antmicro/cm4-baseboard/assets/previews/layer1_thumbnail.webp

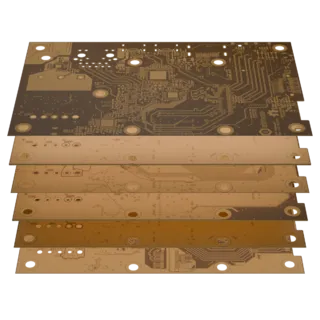
assets/previews/layer1_thumbnail.webp
