antmicro/cm4-baseboard/assets/previews/leftT_thumbnail.png

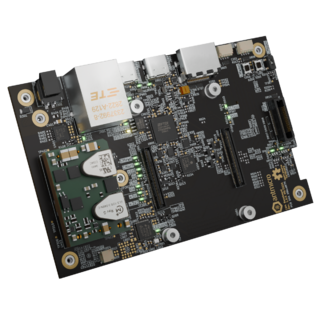
assets/previews/leftT_thumbnail.png
