antmicro/cm4-baseboard/assets/previews/layer0_thumbnail.webp

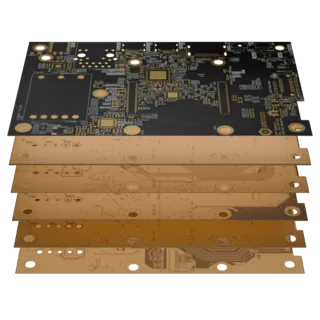
assets/previews/layer0_thumbnail.webp
