antmicro/cm4-baseboard/assets/previews/layer3.png

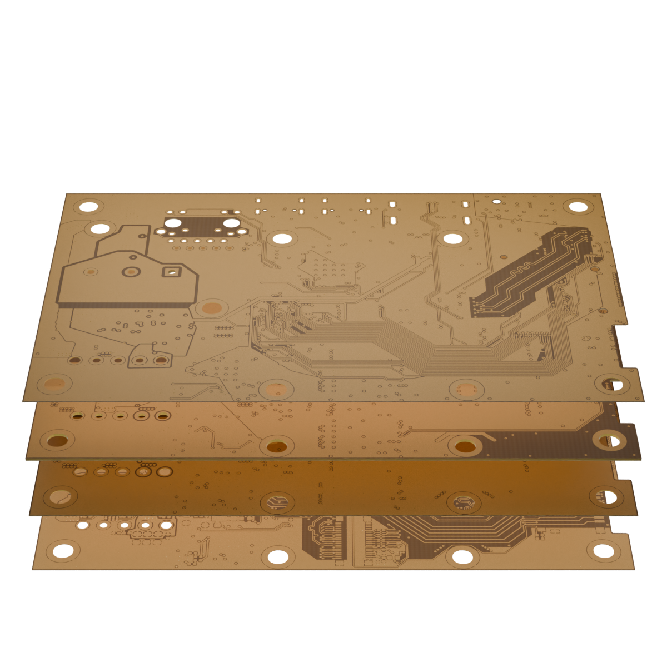
assets/previews/layer3.png
