antmicro/cm4-baseboard/assets/previews/layer5.png

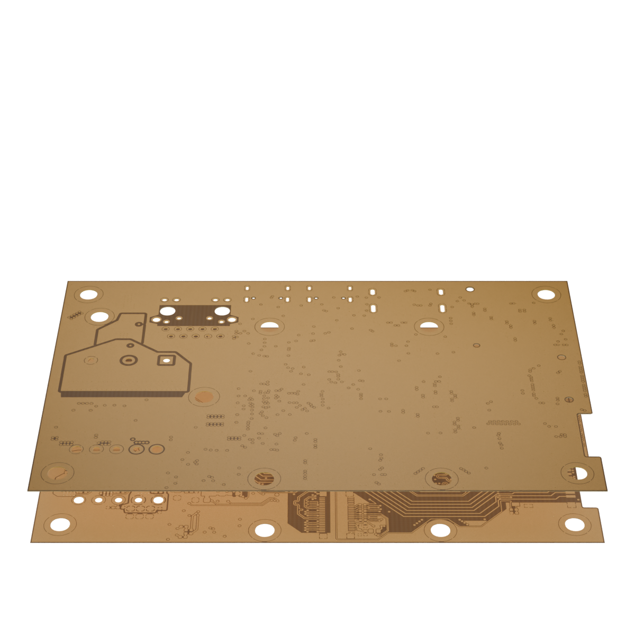
assets/previews/layer5.png
