antmicro/cm4-baseboard/assets/previews/layer6.png

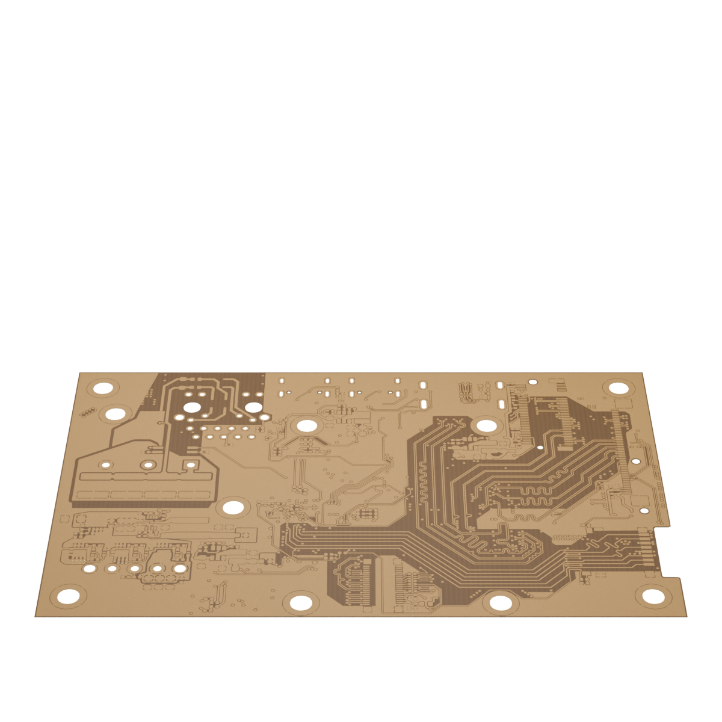
assets/previews/layer6.png
