antmicro/cm4-baseboard/assets/previews/orthoB_photo.webp

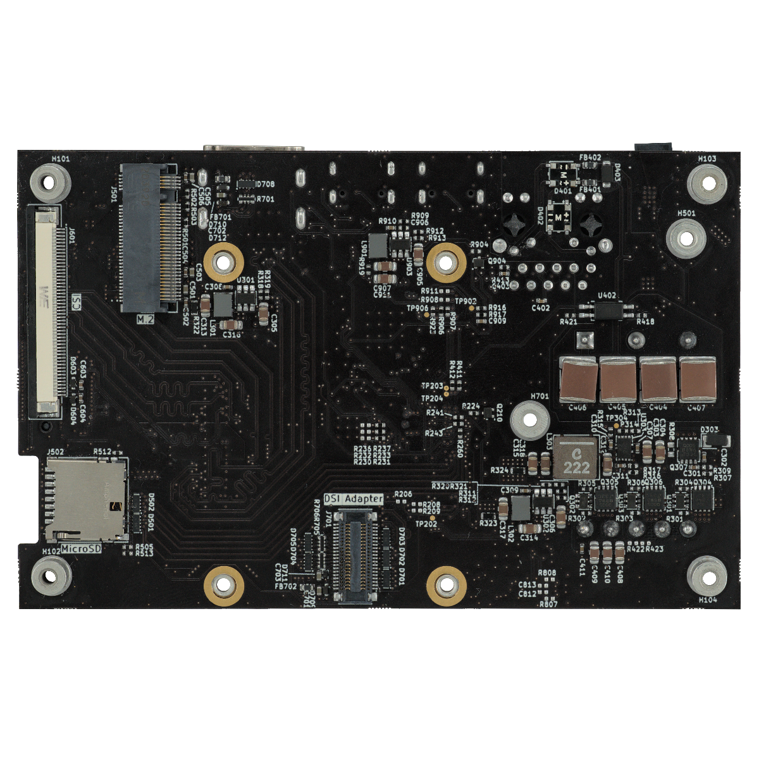
assets/previews/orthoB_photo.webp
