antmicro/cm4-baseboard/assets/previews/orthoT_photo.webp

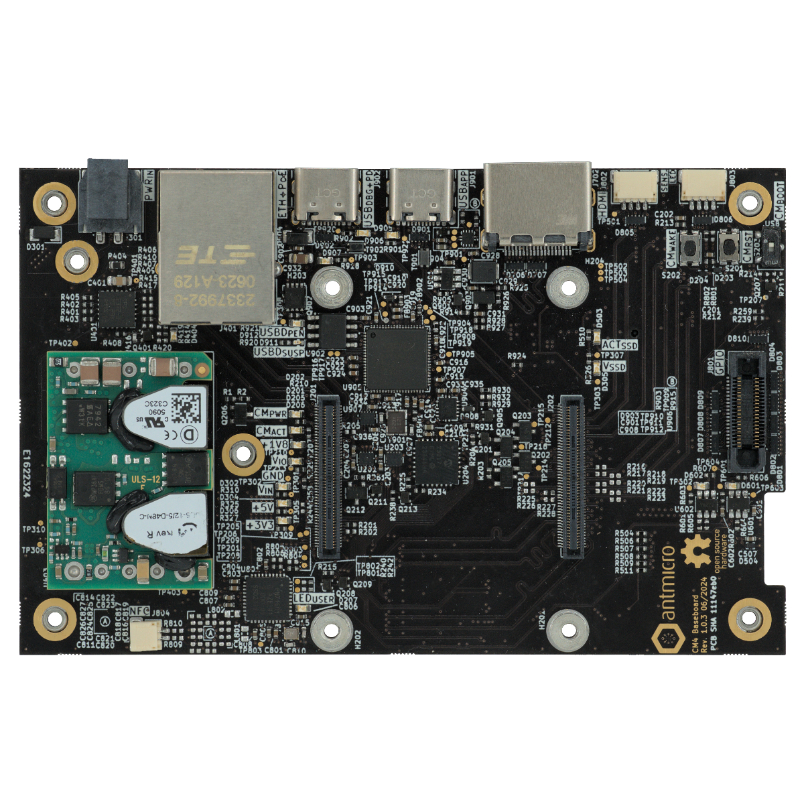
assets/previews/orthoT_photo.webp
