antmicro/cm4-baseboard/assets/wireframe/wireframe_dimensions.png

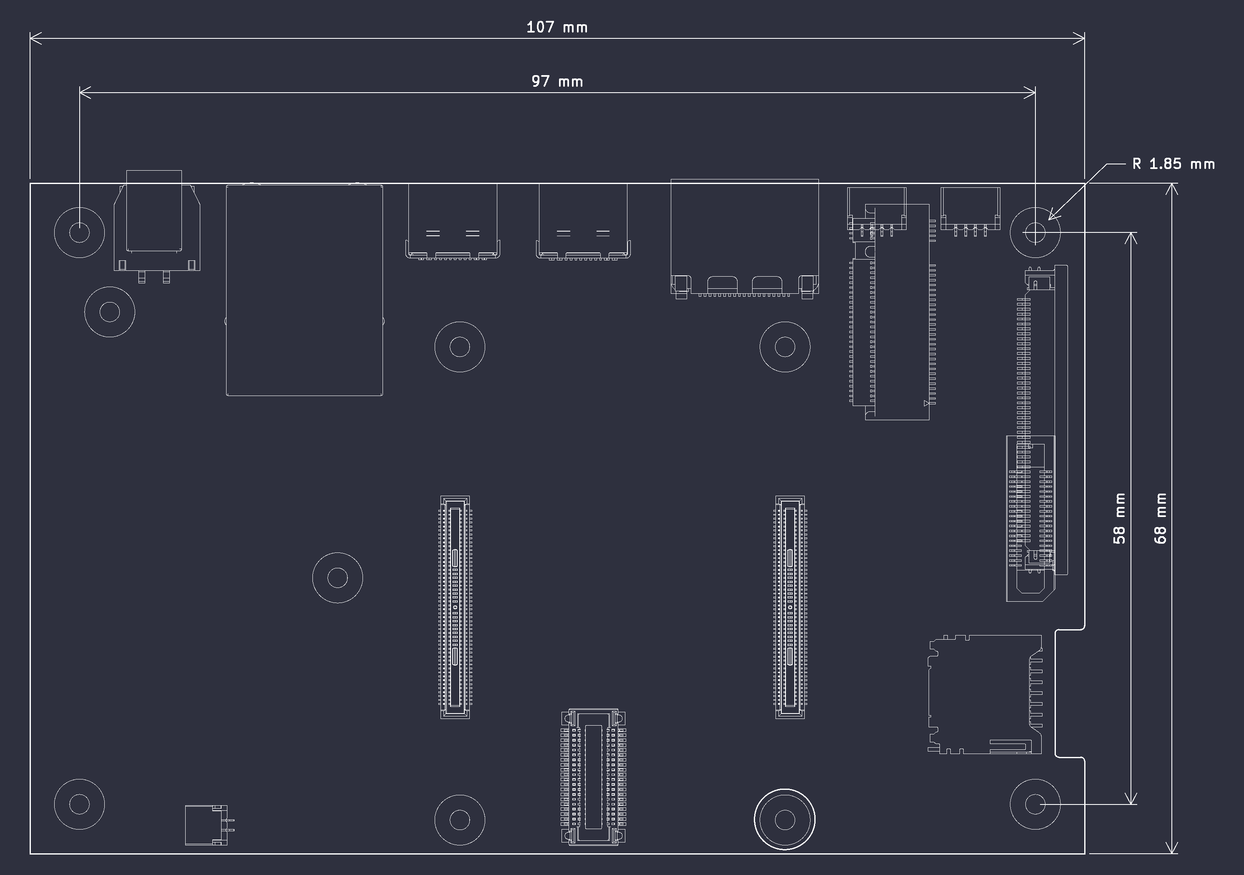
assets/wireframe/wireframe_dimensions.png
