antmicro/cm4-baseboard/assets/wireframe/wireframe_dimensions_bottom.png

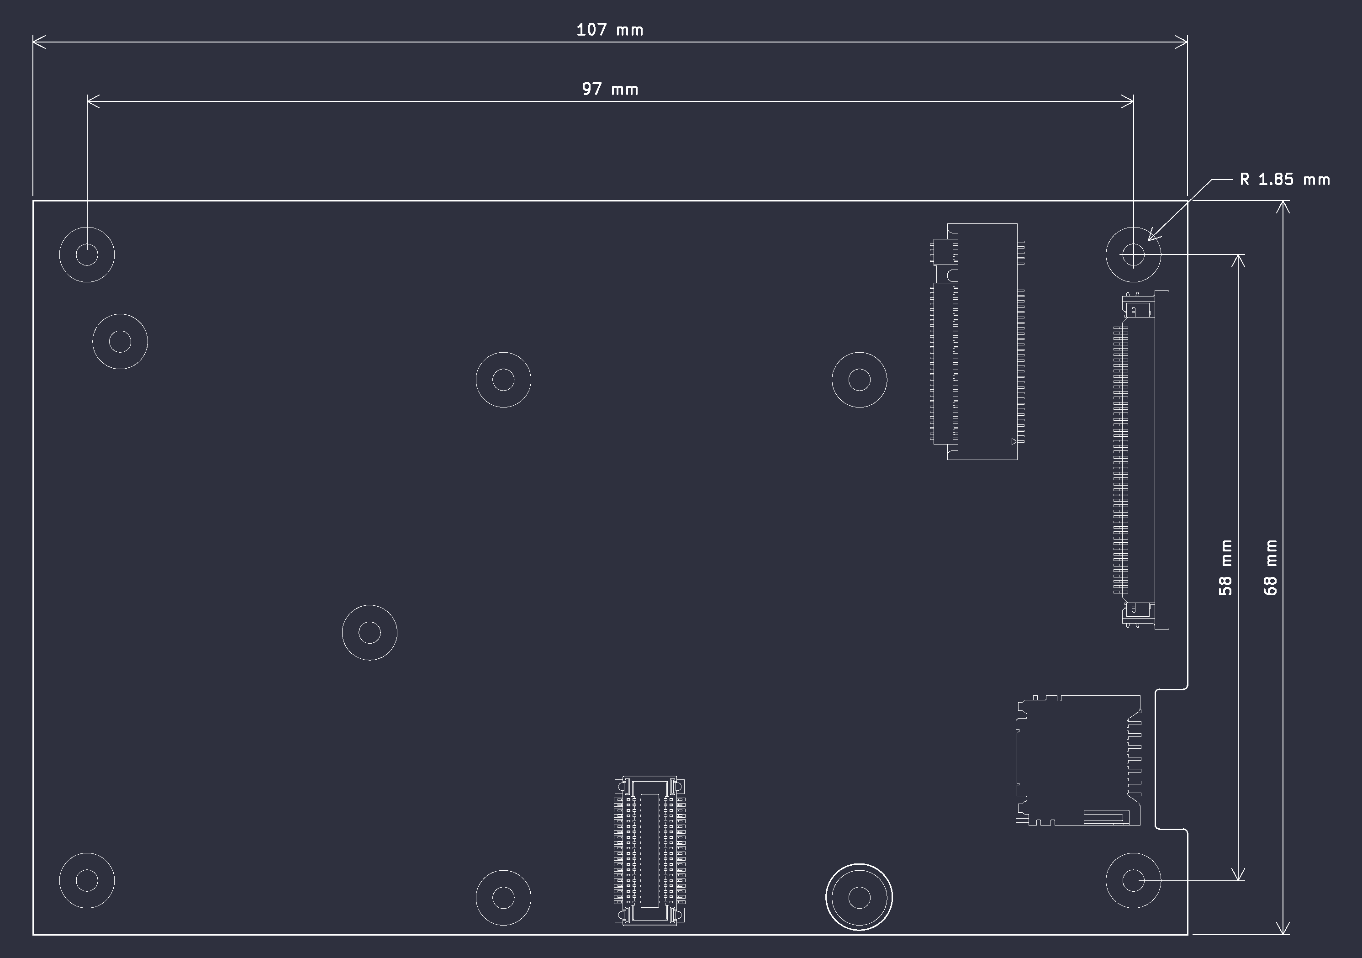
assets/wireframe/wireframe_dimensions_bottom.png
