antmicro/cm4-baseboard/cm4-baseboard.kicad_sch

## KiCad design cm4-baseboard.kicad_sch (2024-09-13)

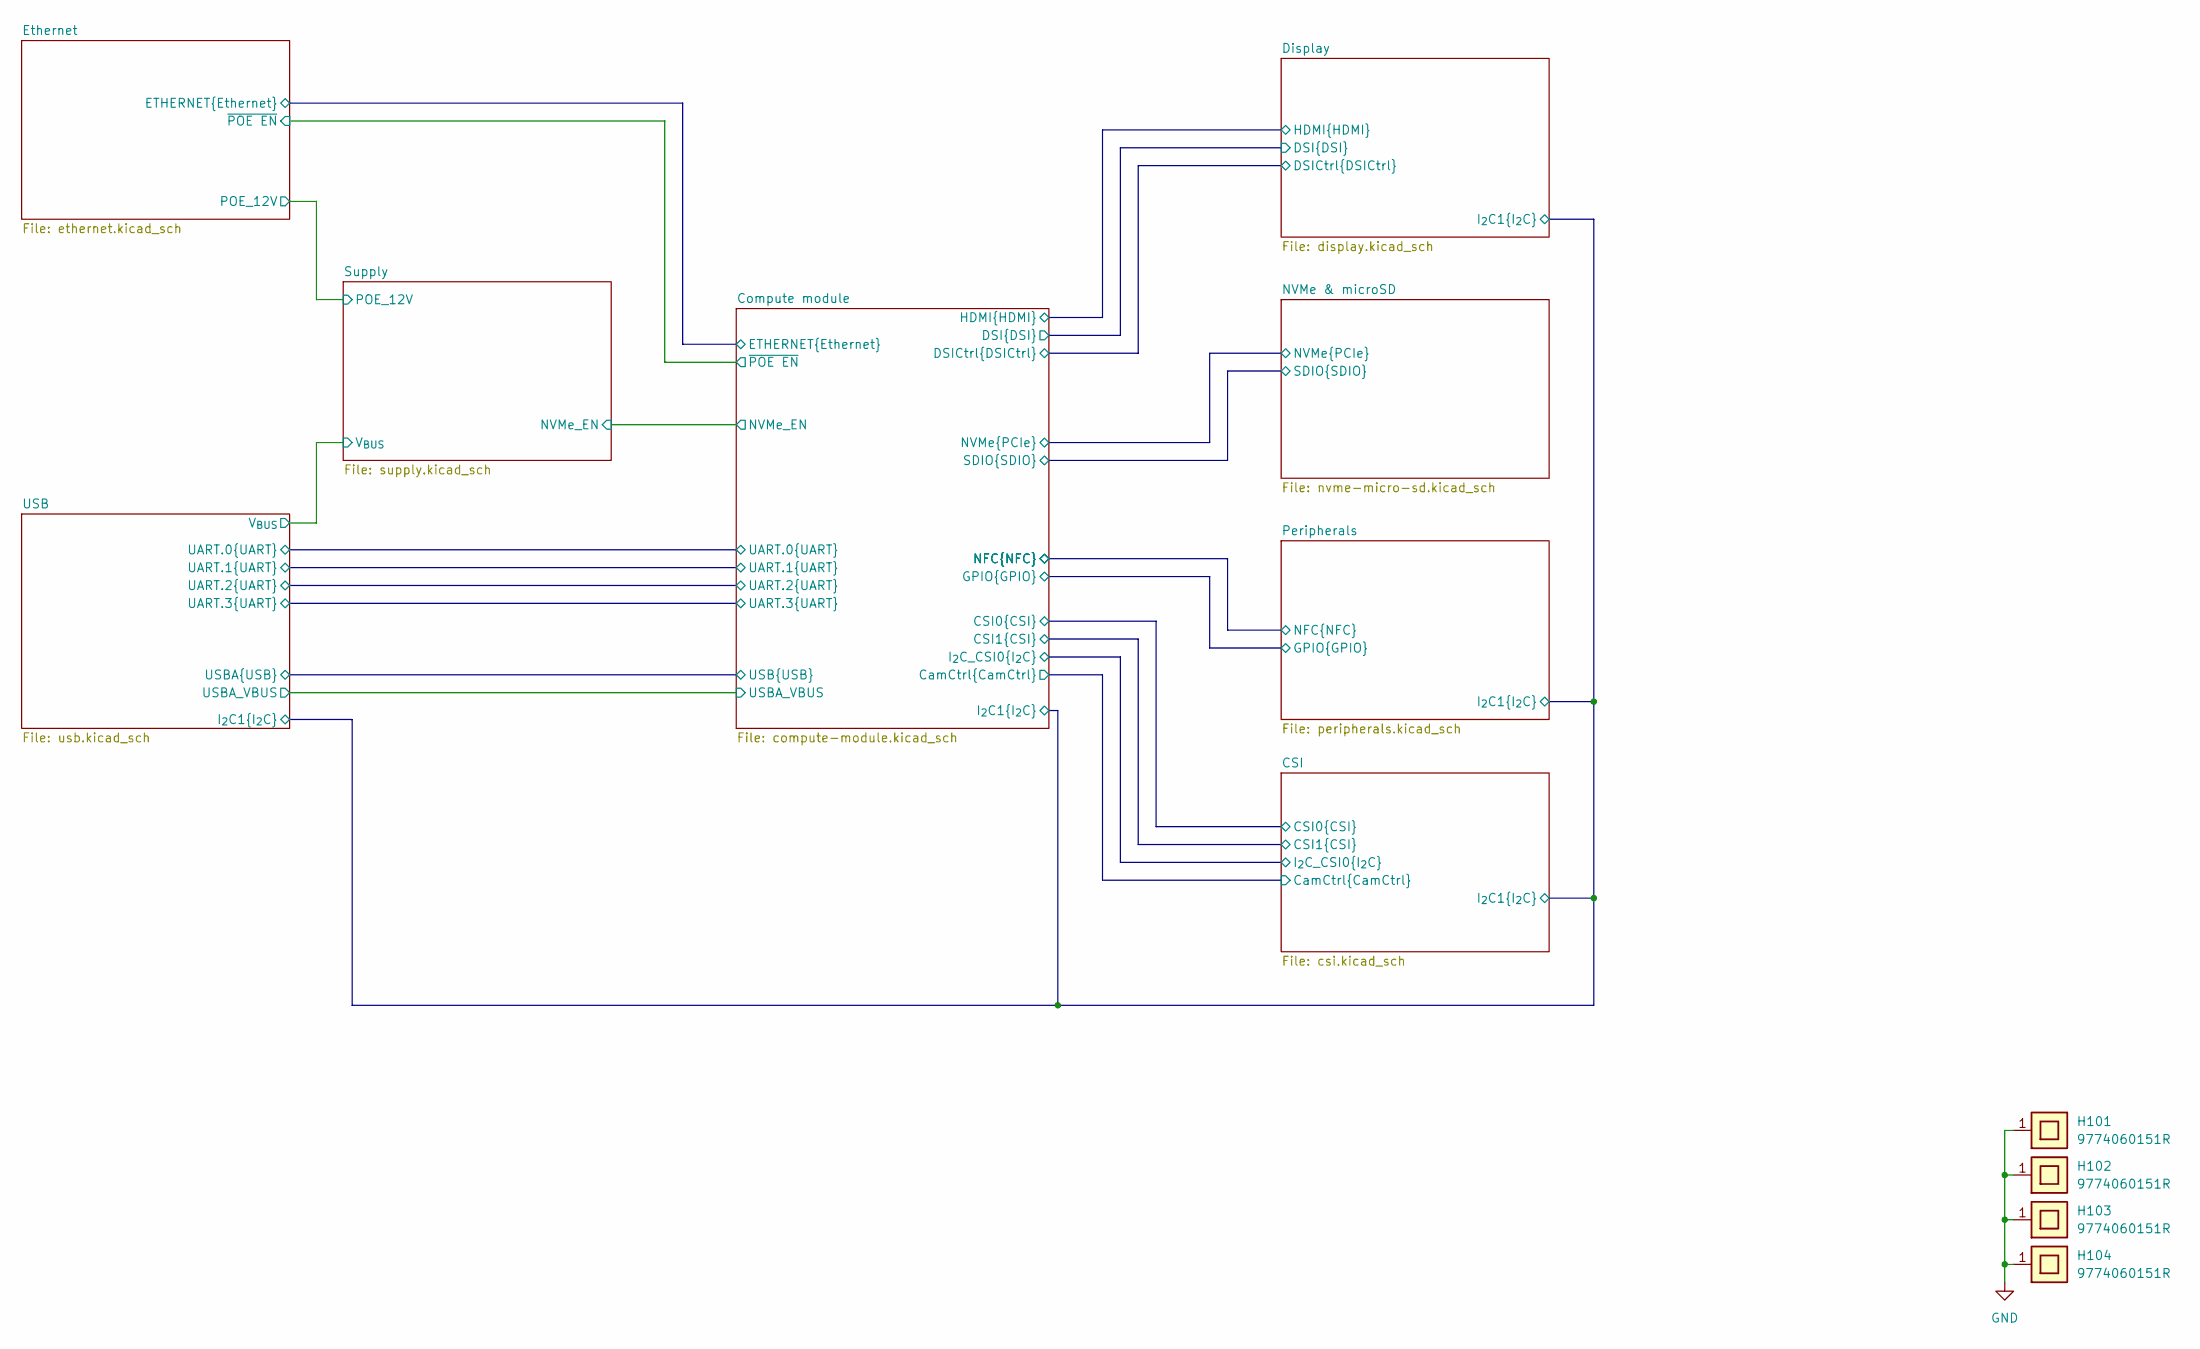
[picture p21: schematic cm4-baseboard.kicad_sch]

Parts:
H101, H102, H103, H104: Spacer_Drill3.7mm_H6mm_9774060151R; MPN 9774060151R

Connections:
GND: H101.1, H102.1, H103.1, H104.1
