antmicro/cm4-baseboard/compute-module.kicad_sch

## KiCad design compute-module.kicad_sch (2024-09-13)

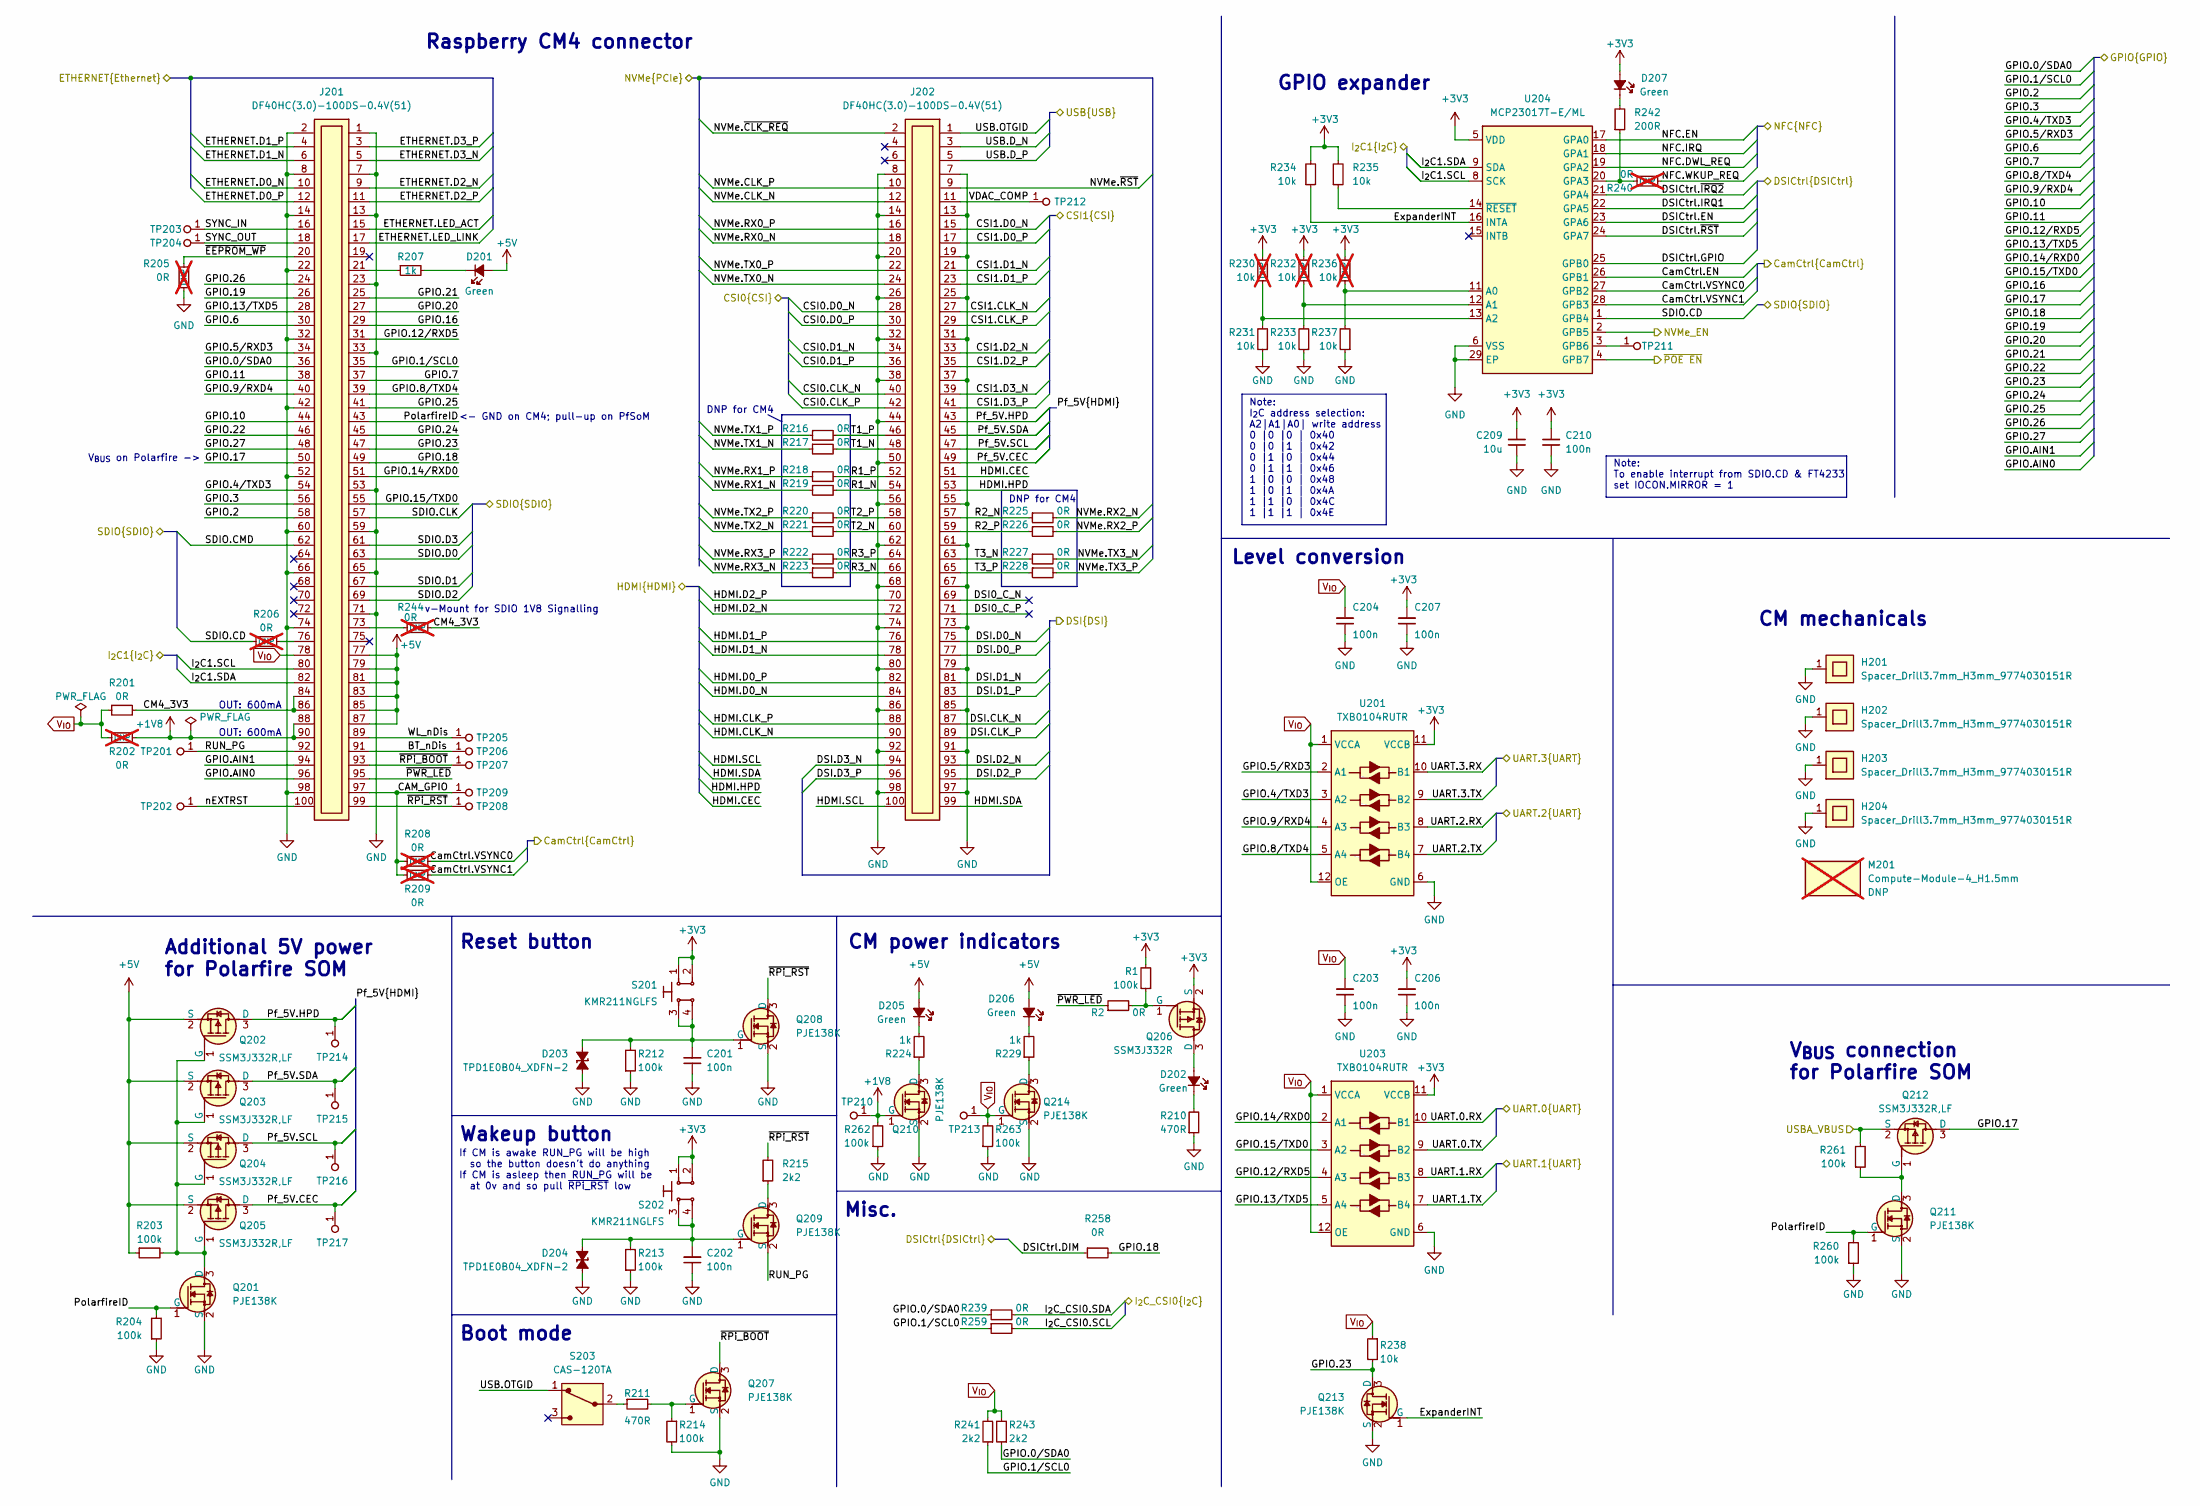
[picture p22: schematic compute-module.kicad_sch]

Parts:
C201, C202, C203, C204, C206, C207, C210: C_100n_0402; C_0402_1005Metric; Voltage 50V; MPN GRM155R61H104KE14D
C209: C_10u_0402; C_0402_1005Metric; MPN CC0402MRX5R5BB106
D201, D202, D205, D206, D207: LED_G_0603_KP-1608CGCK; LED_0603_1608Metric_G; MPN KP-1608CGCK
D203, D204: TPD1E0B04_XDFN-2; XDFN-2_1x0.60mm; MPN TPD1E0B04DPYR
H201, H202, H203, H204: Spacer_Drill3.7mm_H3mm_9774030151R; MPN 9774030151R
J201, J202: Socket_Hirose_DF40_2x50_DF40HC-3.0-100DS-0.4V; Conn_Socket_Hirose_DF40_2x50_DF40HC-3.0-100DS-0.4V; MPN DF40HC(3.0)-100DS-0.4V(51)
M201: Compute-Module-4_H1.5mm; MPN SC0294; not fitted
Q201, Q207, Q208, Q209, Q210, Q211, Q213, Q214: PJE138K; SOT-523; MPN PJE138K_R1_00001
Q202, Q203, Q204, Q205, Q206, Q212: SSM3J332R; SOT-23-3; MPN SSM3J332R,LF
R1, R203, R204, R212, R213, R214, R260, R261, R262, R263: R_100k_0402; R_0402_1005Metric; Tolerance 1%; MPN CR0402-FX-1003GLF
R2, R201, R216, R217, R218, R219, R220, R221, R222, R223, R225, R226, R227, R228, R239, R258, R259: R_0R_0402; R_0402_1005Metric; MPN ERJ2GE0R00X
R202, R205, R206, R208, R209, R240, R244: R_0R_0402; R_0402_1005Metric; MPN ERJ2GE0R00X; not fitted
R207, R224, R229: R_1k_0402; R_0402_1005Metric; Tolerance 1%; MPN CR0402-FX-1001GLF
R210, R211: R_470R_0402; R_0402_1005Metric; Tolerance 1%; MPN CR0402-FX-4700GLF
R215, R241, R243: R_2k2_0402; R_0402_1005Metric; Tolerance 1%; MPN CR0402-FX-2201GLF
R230, R232, R236: R_10k_0402; R_0402_1005Metric; Tolerance 1%; MPN CR0402-FX-1002GLF; not fitted
R231, R233, R234, R235, R237, R238: R_10k_0402; R_0402_1005Metric; Tolerance 1%; MPN CR0402-FX-1002GLF
R242: R_200R_0402; R_0402_1005Metric; Tolerance 1%; MPN CR0402-FX-2000GLF
S201, S202: SW_KMR211NGLFS_SMD; MPN KMR211NGLFS
S203: CAS-120TA; Switch_Slide_CAS-120TA; MPN CAS-120TA
TP201, TP202, TP203, TP204, TP205, TP206, TP207, TP208, TP209, TP210, TP211, TP212, TP213, TP214, TP215, TP216, TP217: TP_0.75mm_SMD; TP_SMD_0.75mm
U201, U203: TXB0104_UQFN; UQFN-12_2x1.7mm_P0.4mm_Texas_RUT; MPN TXB0104RUTR
U204: MCP23017T-E_QFN; QFN-28-1EP_6x6mm_P0.65mm_EP3.7x3.7mm; MPN MCP23017T-E/ML

Connections:
+1V8: J201.88, J201.90, Q210.1 (G), R202.2, R262.2, TP210.1
+3V3: C206.2, C207.2, C209.2, C210.2, D207.2 (A), Q206.2 (S), R1.2, R230.2, R232.2, R234.2, R235.2, R236.2, S201.1, S201.2, S202.1, S202.2, U201.11 (VCCB), U203.11 (VCCB), U204.5 (VDD)
+5V: D201.2 (A), D205.2 (A), D206.2 (A), J201.77, J201.79, J201.81, J201.83, J201.85, J201.87, Q202.2 (S), Q203.2 (S), Q204.2 (S), Q205.2 (S), R203.1
BT_nDis: J201.91, TP206.1
CAM_GPIO: J201.97, R208.1, R209.1, TP209.1
CM4_3V3: J201.84, J201.86, R201.2, R244.1
CSI0.CLK_N: J202.40
CSI0.CLK_P: J202.42
CSI0.D0_N: J202.28
CSI0.D0_P: J202.30
CSI0.D1_N: J202.34
CSI0.D1_P: J202.36
CSI1.CLK_N: J202.27
CSI1.CLK_P: J202.29
CSI1.D0_N: J202.15
CSI1.D0_P: J202.17
CSI1.D1_N: J202.21
CSI1.D1_P: J202.23
CSI1.D2_N: J202.33
CSI1.D2_P: J202.35
CSI1.D3_N: J202.39
CSI1.D3_P: J202.41
CamCtrl.EN: U204.26 (GPB1)
CamCtrl.VSYNC0: R208.2, U204.27 (GPB2)
CamCtrl.VSYNC1: R209.2, U204.28 (GPB3)
DSI0_C_N: J202.69
DSI0_C_P: J202.71
DSI.CLK_N: J202.87
DSI.CLK_P: J202.89
DSI.D0_N: J202.75
DSI.D0_P: J202.77
DSI.D1_N: J202.81
DSI.D1_P: J202.83
DSI.D2_N: J202.93
DSI.D2_P: J202.95
DSI.D3_N: J202.94
DSI.D3_P: J202.96
DSICtrl.DIM: R258.1
DSICtrl.EN: U204.23 (GPA6)
DSICtrl.GPIO: U204.25 (GPB0)
DSICtrl.IRQ1: U204.22 (GPA5)
DSICtrl.~IRQ2: U204.21 (GPA4)
DSICtrl.~RST: U204.24 (GPA7)
ETHERNET.D0_N: J201.10
ETHERNET.D0_P: J201.12
ETHERNET.D1_N: J201.6
ETHERNET.D1_P: J201.4
ETHERNET.D2_N: J201.9
ETHERNET.D2_P: J201.11
ETHERNET.D3_N: J201.5
ETHERNET.D3_P: J201.3
ETHERNET.LED_ACT: J201.15
ETHERNET.LED_LINK: J201.17
ExpanderINT: Q213.1 (G), R234.1, U204.16 (INTA)
GND: C201.1, C202.1, C203.1, C204.1, C206.1, C207.1, C209.1, C210.1, D203.1 (C), D204.1 (C), H201.1, H202.1, H203.1, H204.1, J201.1, J201.2, J201.7, J201.8, J201.13, J201.14, J201.22, J201.23, J201.32, J201.33, J201.42, J201.52, J201.53, J201.59, J201.60, J201.65, J201.66, J201.71, J201.74, J201.98, J202.7, J202.8, J202.13, J202.14, J202.19, J202.20, J202.25, J202.26, J202.31, J202.32, J202.37, J202.38, J202.44, J202.50, J202.55, J202.56, J202.61, J202.62, J202.67, J202.68, J202.73, J202.74, J202.79, J202.80, J202.85, J202.86, J202.91, J202.92, J202.97, J202.98, Q201.2 (S), Q207.2 (S), Q208.2 (S), Q210.2 (S), Q211.2 (S), Q213.2 (S), Q214.2 (S), R204.1, R205.1, R210.1, R212.1, R213.1, R214.2, R231.1, R233.1, R237.1, R260.1, R262.1, R263.1, U201.6 (GND), U203.6 (GND), U204.6 (VSS), U204.29 (EP)
GPIO.0/SDA0: J201.36, R239.1, R243.1
GPIO.1/SCL0: J201.35, R241.1, R259.1
GPIO.2: J201.58
GPIO.3: J201.56
GPIO.4/TXD3: U201.3 (A2)
GPIO.4/TXD3: J201.54
GPIO.5/RXD3: U201.2 (A1)
GPIO.5/RXD3: J201.34
GPIO.6: J201.30
GPIO.7: J201.37
GPIO.8/TXD4: U201.5 (A4)
GPIO.8/TXD4: J201.39
GPIO.9/RXD4: U201.4 (A3)
GPIO.9/RXD4: J201.40
GPIO.10: J201.44
GPIO.11: J201.38
GPIO.12/RXD5: U203.4 (A3)
GPIO.12/RXD5: J201.31
GPIO.13/TXD5: U203.5 (A4)
GPIO.13/TXD5: J201.28
GPIO.14/RXD0: J201.51, U203.2 (A1)
GPIO.15/TXD0: J201.55, U203.3 (A2)
GPIO.16: J201.29
GPIO.17: J201.50, Q212.3 (D)
GPIO.18: J201.49, R258.2
GPIO.19: J201.26
GPIO.20: J201.27
GPIO.21: J201.25
GPIO.22: J201.46
GPIO.23: J201.47, Q213.3 (D), R238.2
GPIO.24: J201.45
GPIO.25: J201.41
GPIO.26: J201.24
GPIO.27: J201.48
GPIO.AIN0: J201.96
GPIO.AIN1: J201.94
HDMI.CEC: J202.51
HDMI.CLK_N: J202.90
HDMI.CLK_P: J202.88
HDMI.D0_N: J202.84
HDMI.D0_P: J202.82
HDMI.D1_N: J202.78
HDMI.D1_P: J202.76
HDMI.D2_N: J202.72
HDMI.D2_P: J202.70
HDMI.HPD: J202.53
HDMI.SCL: J202.100
HDMI.SDA: J202.99
I_{2}C1.SCL: J201.80, U204.8 (SCK)
I_{2}C1.SDA: J201.82, U204.9 (SDA)
I_{2}C_CSI0.SCL: R259.2
I_{2}C_CSI0.SDA: R239.2
NFC.DWL_REQ: U204.19 (GPA2)
NFC.EN: U204.17 (GPA0)
NFC.IRQ: U204.18 (GPA1)
NFC.WKUP_REQ: R240.2
NVMe.CLK_N: J202.12
NVMe.CLK_P: J202.10
NVMe.RX0_N: J202.18
NVMe.RX0_P: J202.16
NVMe.RX1_N: R219.1
NVMe.RX1_P: R218.1
NVMe.RX2_N: R225.2
NVMe.RX2_P: R226.2
NVMe.RX3_N: R223.1
NVMe.RX3_P: R222.1
NVMe.TX0_N: J202.24
NVMe.TX0_P: J202.22
NVMe.TX1_N: R217.1
NVMe.TX1_P: R216.1
NVMe.TX2_N: R221.1
NVMe.TX2_P: R220.1
NVMe.TX3_N: R227.2
NVMe.TX3_P: R228.2
NVMe.~CLK_REQ: J202.2
NVMe.~RST: J202.9
NVMe_EN: U204.2 (GPB5)
unnamed: C201.2, D203.2 (A), Q208.1 (G), R212.2, S201.3, S201.4
unnamed: C202.2, D204.2 (A), Q209.1 (G), R213.2, S202.3, S202.4
unnamed: D201.1 (C), R207.2
unnamed: D202.1 (C), R210.2
unnamed: D202.2 (A), Q206.3 (D)
unnamed: D205.1 (C), R224.2
unnamed: D206.1 (C), R229.2
unnamed: D207.1 (C), R242.2
unnamed: J201.21, R207.1
unnamed: J201.73, R244.2
unnamed: J201.76, R206.1
unnamed: Q201.3 (D), Q202.1 (G), Q203.1 (G), Q204.1 (G), Q205.1 (G), R203.2
unnamed: Q206.1 (G), R1.1, R2.2
unnamed: Q207.1 (G), R211.2, R214.1
unnamed: Q209.3 (D), R215.1
unnamed: Q210.3 (D), R224.1
unnamed: Q211.3 (D), Q212.1 (G), R261.1
unnamed: Q214.3 (D), R229.1
unnamed: R211.1, S203.2
unnamed: R230.1, R231.2, U204.13 (A2)
unnamed: R232.1, R233.2, U204.12 (A1)
unnamed: R235.1, U204.14 (~RESET)
unnamed: R236.1, R237.2, U204.11 (A0)
unnamed: R240.1, R242.1, U204.20 (GPA3)
unnamed: TP211.1, U204.3 (GPB6)
Pf_5V.CEC: J202.49, Q205.3 (D), TP217.1
Pf_5V.HPD: J202.43, Q202.3 (D), TP214.1
Pf_5V.SCL: J202.47, Q204.3 (D), TP216.1
Pf_5V.SDA: J202.45, Q203.3 (D), TP215.1
PolarfireID: J201.43, Q201.1 (G), Q211.1 (G), R204.2, R260.2
R1_N: J202.54, R219.2
R1_P: J202.52, R218.2
R2_N: J202.57, R225.1
R2_P: J202.59, R226.1
R3_N: J202.66, R223.2
R3_P: J202.64, R222.2
RUN_PG: J201.92, Q209.2 (S), TP201.1
SDIO.CD: R206.2, U204.1 (GPB4)
SDIO.CLK: J201.57
SDIO.CMD: J201.62
SDIO.D0: J201.63
SDIO.D1: J201.67
SDIO.D2: J201.69
SDIO.D3: J201.61
SYNC_IN: J201.16, TP203.1
SYNC_OUT: J201.18, TP204.1
T1_N: J202.48, R217.2
T1_P: J202.46, R216.2
T2_N: J202.60, R221.2
T2_P: J202.58, R220.2
T3_N: J202.63, R227.1
T3_P: J202.65, R228.1
UART.0.RX: U203.10 (B1)
UART.0.TX: U203.9 (B2)
UART.1.RX: U203.8 (B3)
UART.1.TX: U203.7 (B4)
UART.2.RX: U201.8 (B3)
UART.2.TX: U201.7 (B4)
UART.3.RX: U201.10 (B1)
UART.3.TX: U201.9 (B2)
USB.D_N: J202.3
USB.D_P: J202.5
USB.OTGID: J202.1, S203.1
USBA_VBUS: Q212.2 (S), R261.2
VDAC_COMP: J202.11, TP212.1
V_{IO}: C203.2, C204.2, J201.78, Q214.1 (G), R201.1, R202.1, R238.1, R241.2, R243.2, R263.2, TP213.1, U201.1 (VCCA), U201.12 (OE), U203.1 (VCCA), U203.12 (OE)
WL_nDis: J201.89, TP205.1
nEXTRST: J201.100, TP202.1
~EEPROM_WP: J201.20, R205.2
~POE EN: U204.4 (GPB7)
~PWR_LED: J201.95, R2.1
~RPi_BOOT: J201.93, Q207.3 (D), TP207.1
~RPi_RST: J201.99, Q208.3 (D), R215.2, TP208.1

Notes on the sheet:
Boot mode
Misc.
OUT: 600mA
DNP for CM4
Wakeup button
Raspberry CM4 connector
v-Mount for SDIO 1V8 Signalling
If CM is awake RUN_PG will be high so the button doesn't do anything If CM is asleep then RUN_PG will be at 0v and so pull ~{RPi_RST} low
GPIO expander
Additional 5V power for Polarfire SOM
<- GND on CM4; pull-up on PfSoM
Level conversion
Note: To enable interrupt from SDIO.CD & FT4233 set IOCON.MIRROR = 1
V_{BUS} connection for Polarfire SOM
CM mechanicals
V_{BUS} on Polarfire ->
Note: I_{2}C address selection: A2|A1|A0| write address 0 |0 |0 | 0x40 0 |0 |1 | 0x42 0 |1 |0 | 0x44 0 |1 |1 | 0x46 1 |0 |0 | 0x48 1 |0 |1 | 0x4A 1 |1 |0 | 0x4C 1 |1 |1 | 0x4E
CM power indicators
Reset button
