antmicro/cm4-baseboard/csi.kicad_sch

## KiCad design csi.kicad_sch (2024-09-13)

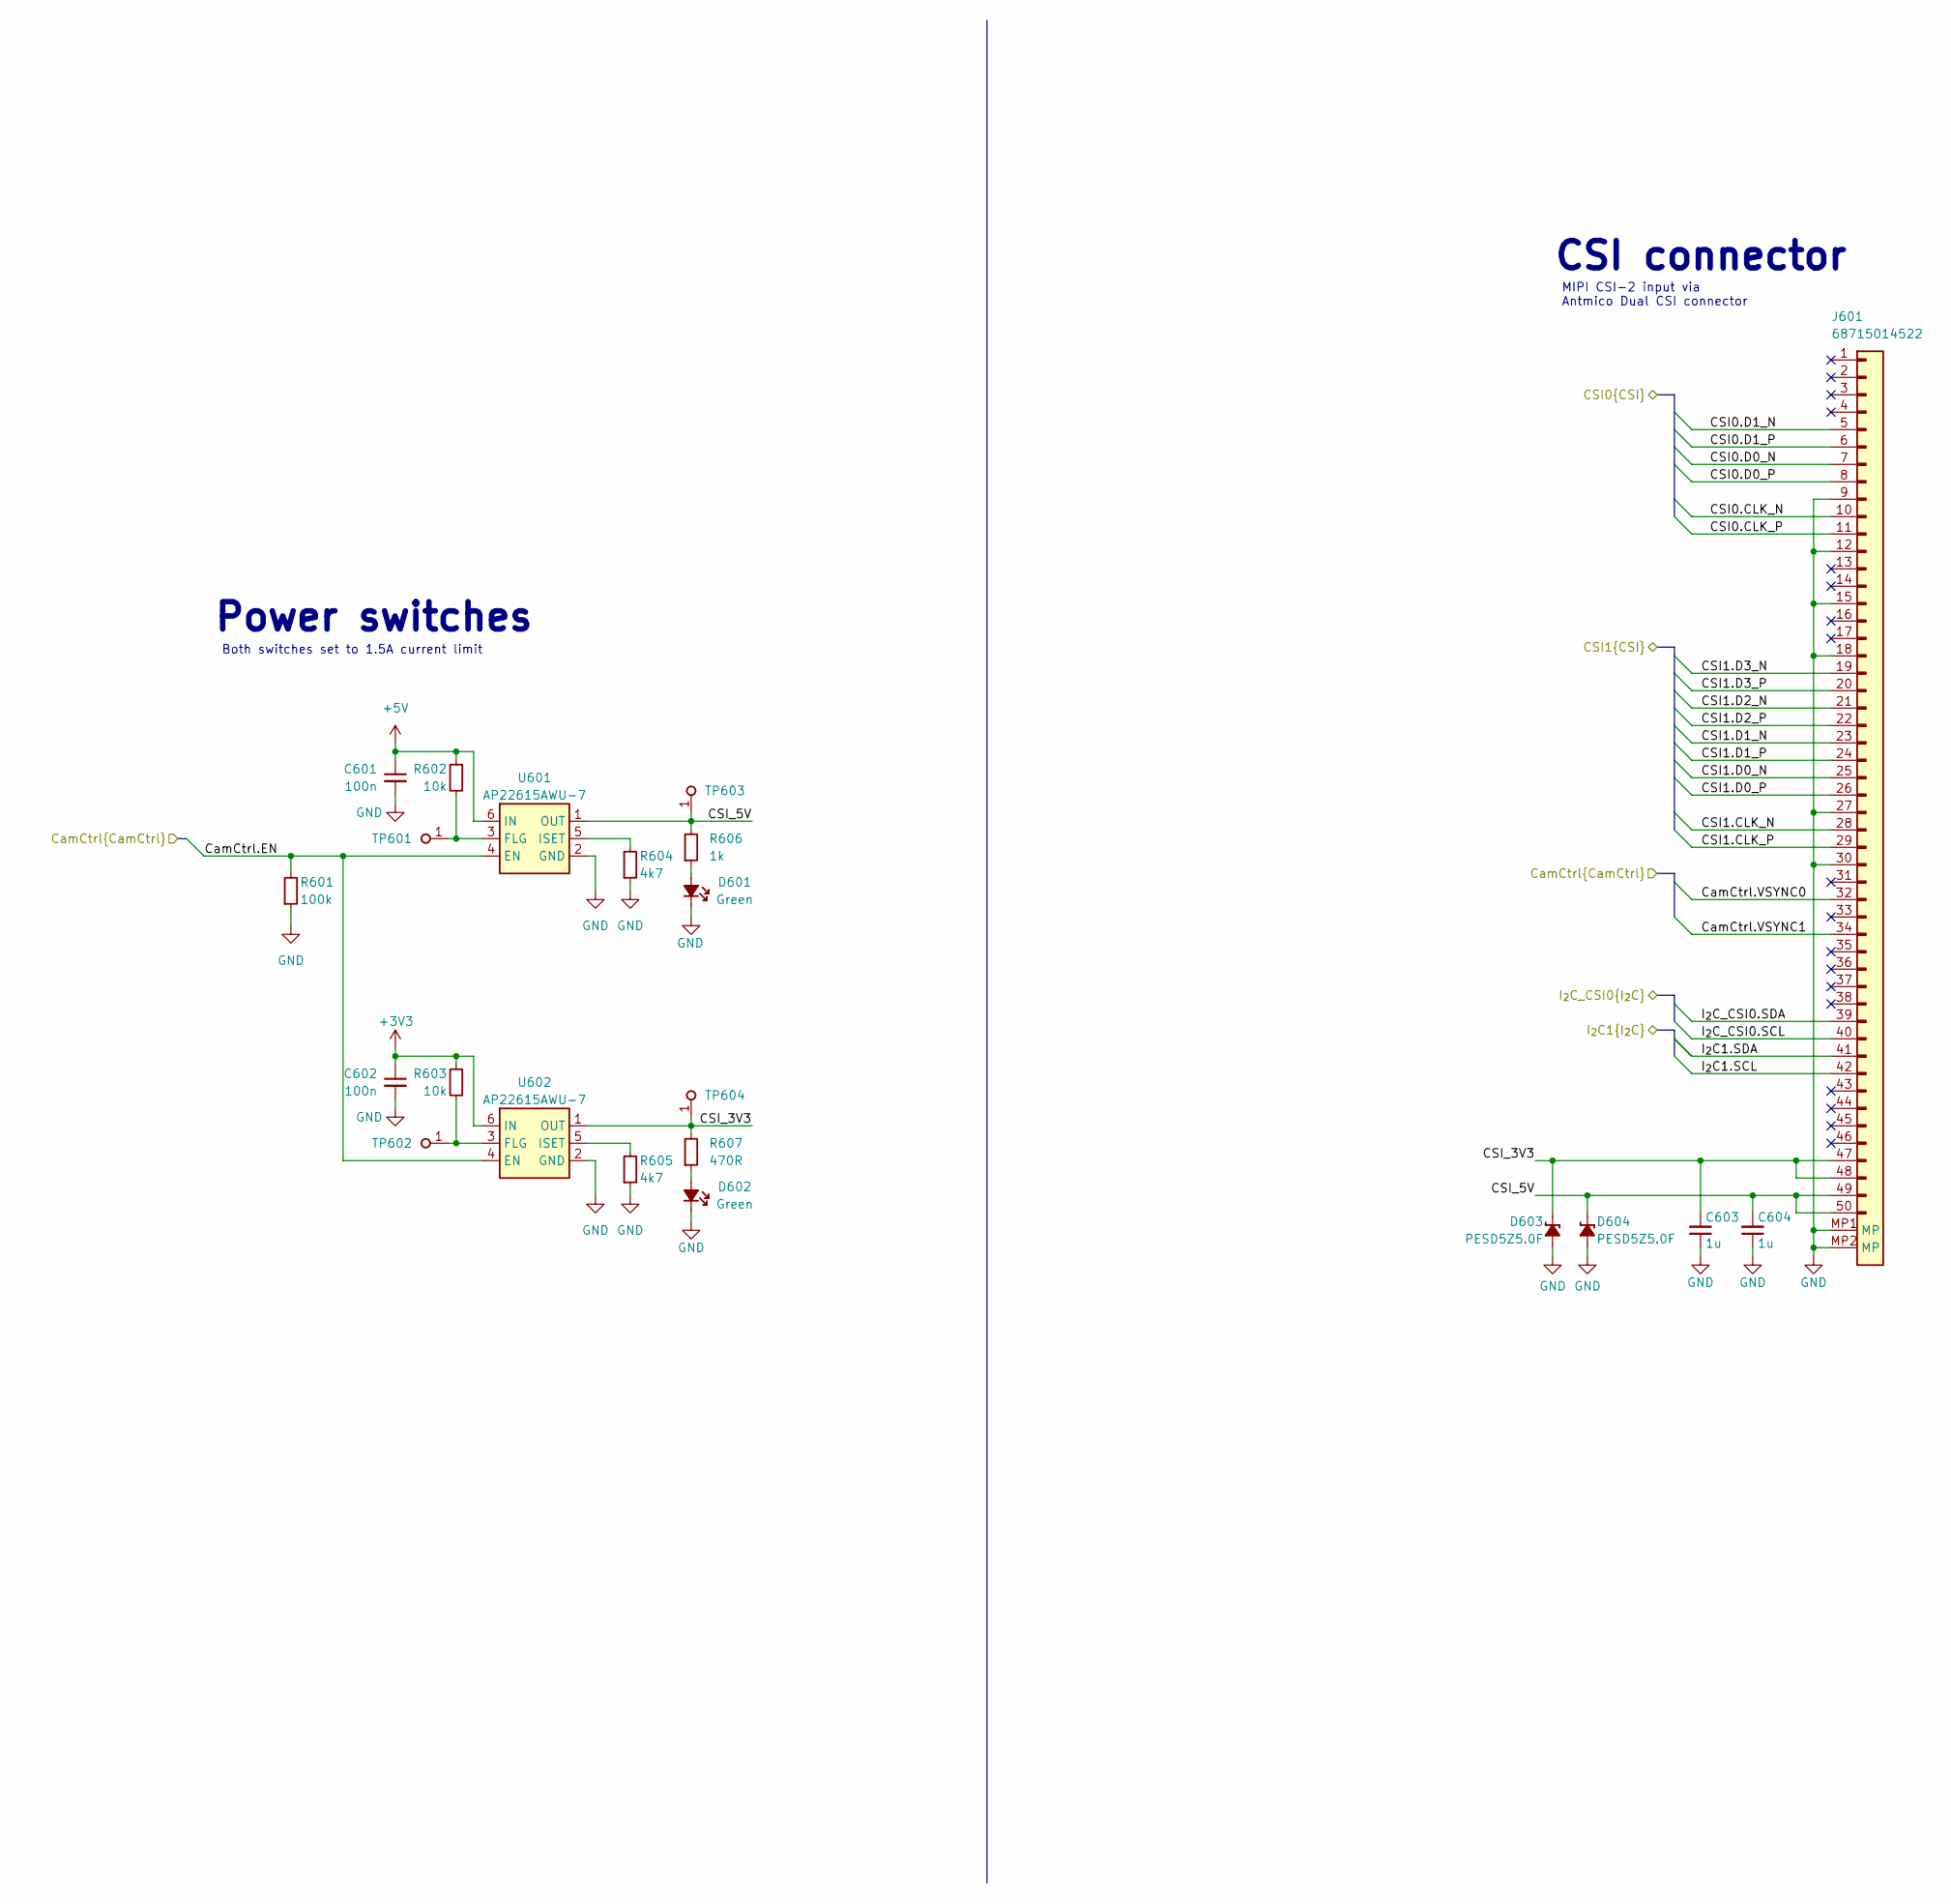
[picture p23: schematic csi.kicad_sch]

Parts:
C601, C602: C_100n_0402; C_0402_1005Metric; Voltage 50V; MPN GRM155R61H104KE14D
C603, C604: C_1u_0402; C_0402_1005Metric; MPN C1005X6S1A105K050BC
D601, D602: LED_G_0603_KP-1608CGCK; LED_0603_1608Metric_G; MPN KP-1608CGCK
D603, D604: PESD5Z5_0F; SOD-523; MPN PESD5Z5.0F
J601: Conn_FFC_WE_68715014522; Conn_FFC_WE_68715014x22; MPN 68715014522
R601: R_100k_0402; R_0402_1005Metric; Tolerance 1%; MPN CR0402-FX-1003GLF
R602, R603: R_10k_0402; R_0402_1005Metric; Tolerance 1%; MPN CR0402-FX-1002GLF
R604, R605: R_4k7_0402; R_0402_1005Metric; Tolerance 1%; MPN CR0402-FX-4701GLF
R606: R_1k_0402; R_0402_1005Metric; Tolerance 1%; MPN CR0402-FX-1001GLF
R607: R_470R_0402; R_0402_1005Metric; Tolerance 1%; MPN CR0402-FX-4700GLF
TP601, TP602, TP603, TP604: TP_0.75mm_SMD; TP_SMD_0.75mm
U601, U602: AP22615A_TSOT26; TSOT23-6; MPN AP22615AWU-7

Connections:
+3V3: C602.1, R603.1, U602.6 (IN)
+5V: C601.1, R602.1, U601.6 (IN)
CSI0.CLK_N: J601.10
CSI0.CLK_P: J601.11
CSI0.D0_N: J601.7
CSI0.D0_P: J601.8
CSI0.D1_N: J601.5
CSI0.D1_P: J601.6
CSI1.CLK_N: J601.28
CSI1.CLK_P: J601.29
CSI1.D0_N: J601.25
CSI1.D0_P: J601.26
CSI1.D1_N: J601.23
CSI1.D1_P: J601.24
CSI1.D2_N: J601.21
CSI1.D2_P: J601.22
CSI1.D3_N: J601.19
CSI1.D3_P: J601.20
CSI_3V3: C603.2, D603.1 (C), J601.47, J601.48, R607.2, TP604.1, U602.1 (OUT)
CSI_5V: C604.2, D604.1 (C), J601.49, J601.50, R606.2, TP603.1, U601.1 (OUT)
CamCtrl.EN: R601.2, U601.4 (EN), U602.4 (EN)
CamCtrl.VSYNC0: J601.32
CamCtrl.VSYNC1: J601.34
GND: C601.2, C602.2, C603.1, C604.1, D601.1 (C), D602.1 (C), D603.2 (A), D604.2 (A), J601.9, J601.12, J601.15, J601.18, J601.27, J601.30, J601.MP1 (MP), J601.MP2 (MP), R601.1, R604.1, R605.1, U601.2 (GND), U602.2 (GND)
I_{2}C1.SCL: J601.42
I_{2}C1.SDA: J601.41
I_{2}C_CSI0.SCL: J601.40
I_{2}C_CSI0.SDA: J601.39
unnamed: D601.2 (A), R606.1
unnamed: D602.2 (A), R607.1
unnamed: R602.2, TP601.1, U601.3 (FLG)
unnamed: R603.2, TP602.1, U602.3 (FLG)
unnamed: R604.2, U601.5 (ISET)
unnamed: R605.2, U602.5 (ISET)

Notes on the sheet:
Power switches
CSI connector
MIPI CSI-2 input via Antmico Dual CSI connector
Both switches set to 1.5A current limit
