antmicro/cm4-baseboard/display.kicad_sch

## KiCad design display.kicad_sch (2024-09-13)

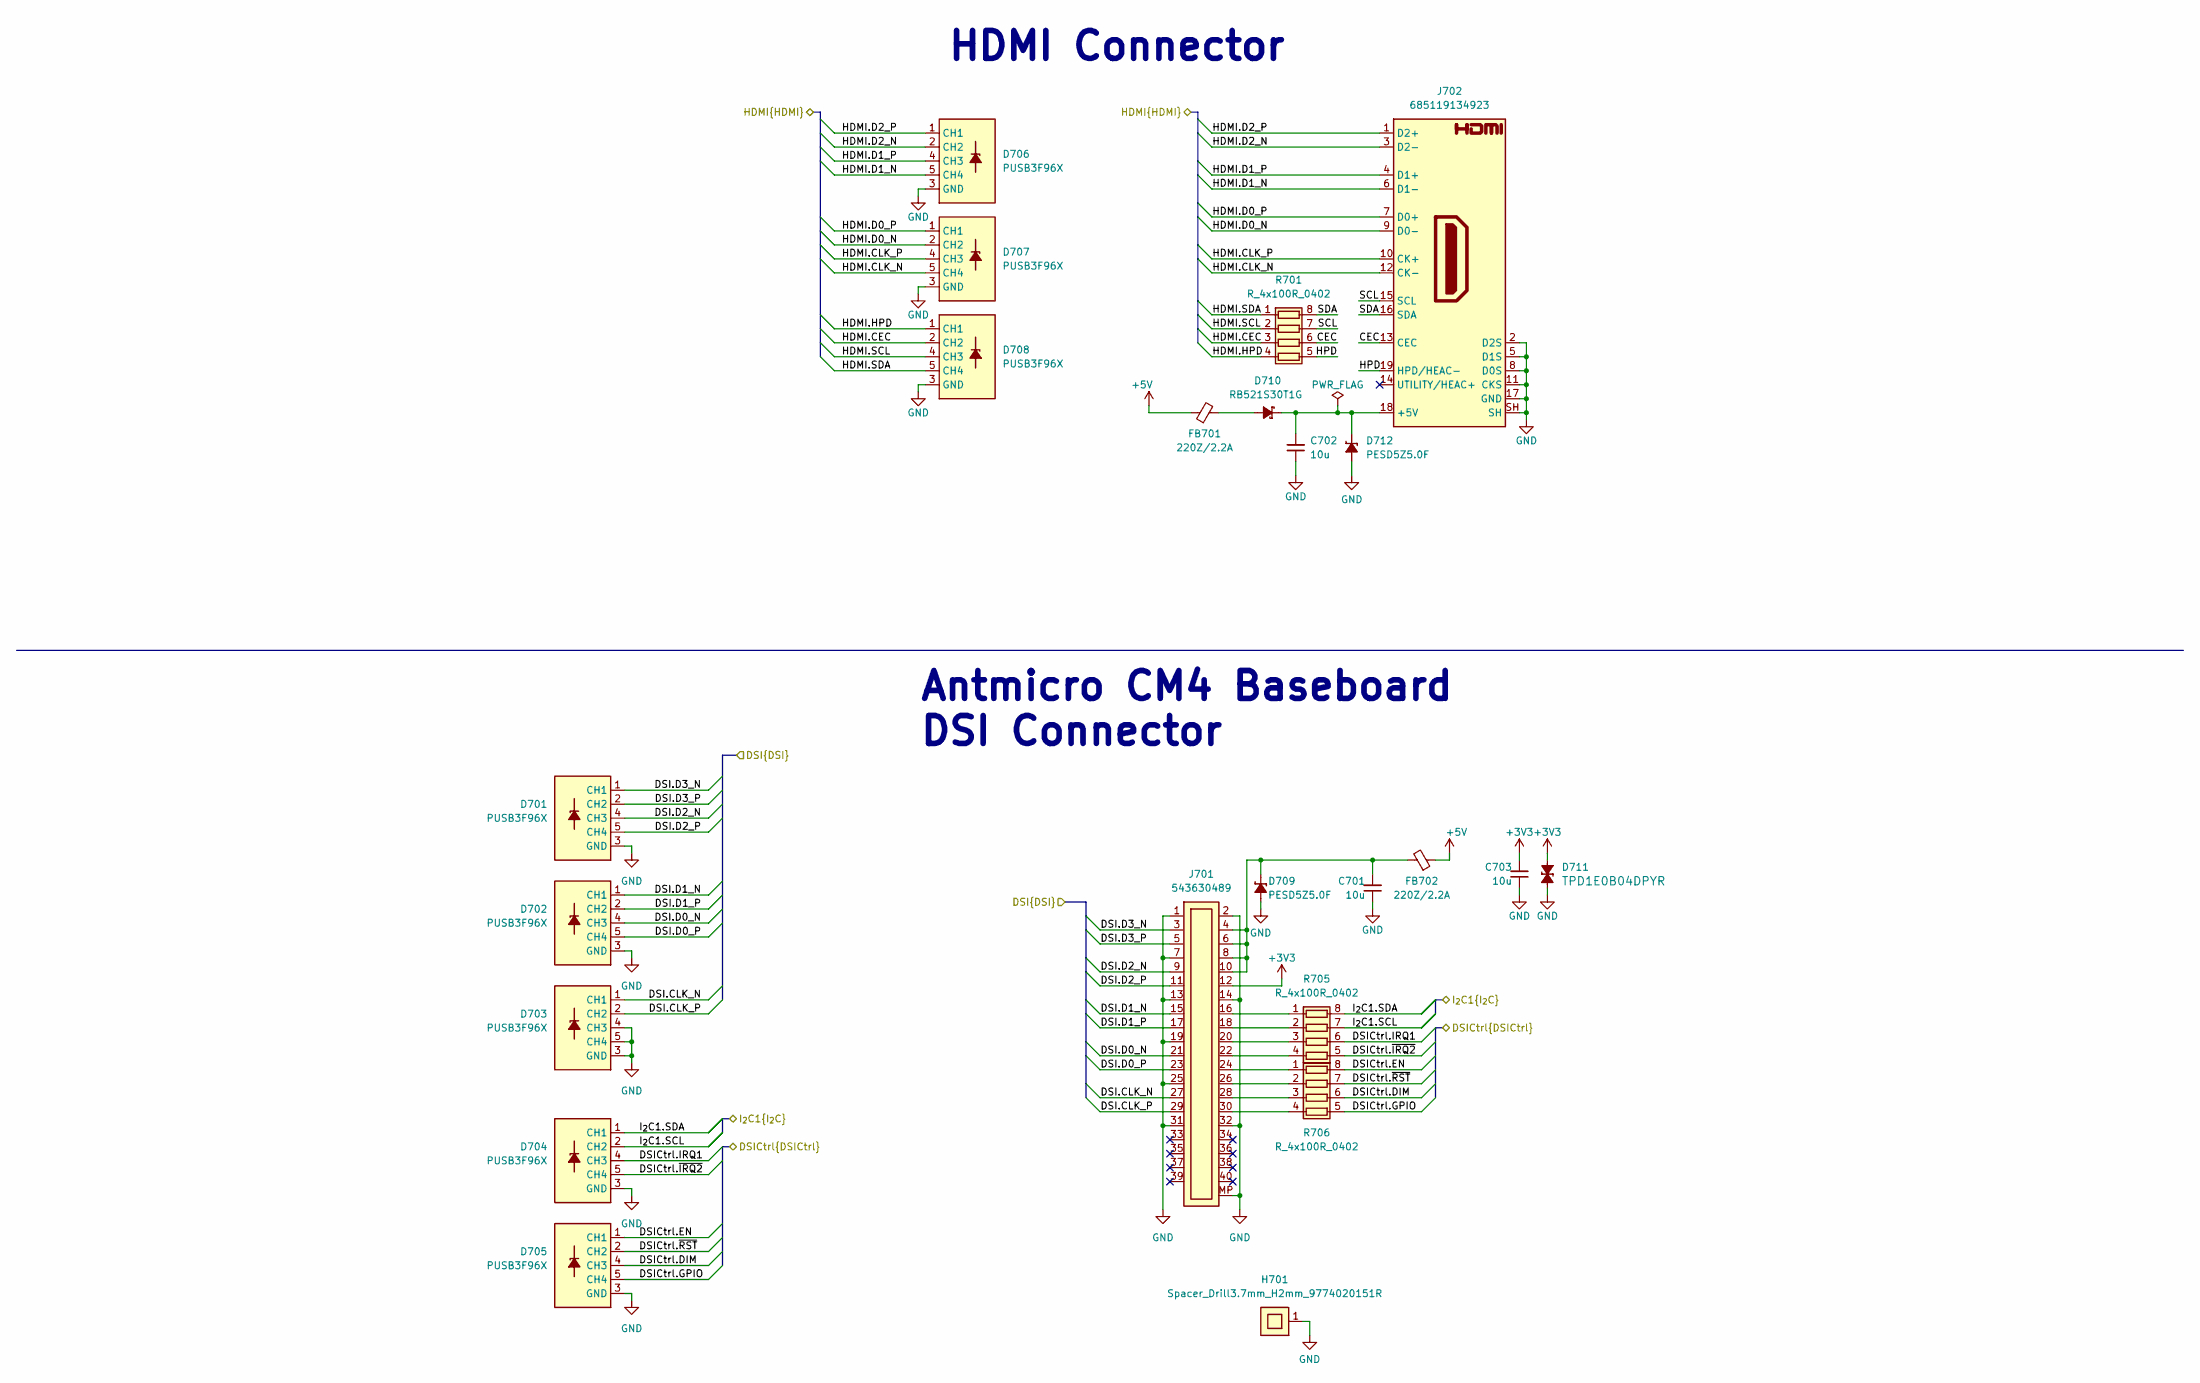
[picture p24: schematic display.kicad_sch]

Parts:
C701, C702, C703: C_10u_0402; C_0402_1005Metric; MPN CC0402MRX5R5BB106
D701, D702, D703, D704, D705, D706, D707, D708: PUSB3F96X_PASS; Nexperia_DFN-10_2.5x1mm_P0.5mm; MPN PUSB3F96X
D709, D712: PESD5Z5_0F; SOD-523; MPN PESD5Z5.0F
D710: RB521S30T1G; SOD-523; MPN RB521S30T1G
D711: TPD1E0B04_XDFN-2; XDFN-2_1x0.60mm; MPN TPD1E0B04DPYR
FB701, FB702: FB_220Z_2.2A_TDK-MPZ_0603; FB_0603_1608Metric; MPN MPZ1608S221ATA00
H701: Spacer_Drill3.7mm_H2mm_9774020151R; MPN 9774020151R
J701: Socket_Molex_SlimStack_2x20_543630489; Conn_Socket_Molex_SlimStack_2x20_543630489; MPN 543630489
J702: HDMI-A_WE_685119134923; HDMI-A_Receptacle_WE_685119134923; MPN 685119134923
R701: R_4x100R_0402_array; R_Array_4x0402_Panasonic_EXB28V; Tolerance 1%; MPN EXB-28V101JX
R705, R706: R_4x100R_0402_array; R_Array_4x0402_Panasonic_EXB28V; MPN EXB-28V101JX

Connections:
+3V3: C703.2, D711.2 (A), J701.12
+5V: FB701.1, FB702.1
CEC: J702.13 (CEC), R701.6 (R3.2)
DSI.CLK_N: D703.1 (CH1), D703.10 (CH1), J701.27
DSI.CLK_P: D703.2 (CH2), D703.9 (CH2), J701.29
DSI.D0_N: D702.4 (CH3), D702.7 (CH3), J701.21
DSI.D0_P: D702.5 (CH4), D702.6 (CH4), J701.23
DSI.D1_N: D702.1 (CH1), D702.10 (CH1), J701.15
DSI.D1_P: D702.2 (CH2), D702.9 (CH2), J701.17
DSI.D2_N: D701.4 (CH3), D701.7 (CH3), J701.9
DSI.D2_P: D701.5 (CH4), D701.6 (CH4), J701.11
DSI.D3_N: D701.1 (CH1), D701.10 (CH1), J701.3
DSI.D3_P: D701.2 (CH2), D701.9 (CH2), J701.5
DSICtrl.DIM: D705.4 (CH3), D705.7 (CH3), R706.6 (R3.2)
DSICtrl.EN: D705.1 (CH1), D705.10 (CH1), R706.8 (R1.2)
DSICtrl.GPIO: D705.5 (CH4), D705.6 (CH4), R706.5 (R4.2)
DSICtrl.IRQ1: D704.4 (CH3), D704.7 (CH3), R705.6 (R3.2)
DSICtrl.~IRQ2: D704.5 (CH4), D704.6 (CH4), R705.5 (R4.2)
DSICtrl.~RST: D705.2 (CH2), D705.9 (CH2), R706.7 (R2.2)
GND: C701.1, C702.1, C703.1, D701.3 (GND), D701.8 (GND), D702.3 (GND), D702.8 (GND), D703.3 (GND), D703.4 (CH3), D703.5 (CH4), D703.6 (CH4), D703.7 (CH3), D703.8 (GND), D704.3 (GND), D704.8 (GND), D705.3 (GND), D705.8 (GND), D706.3 (GND), D706.8 (GND), D707.3 (GND), D707.8 (GND), D708.3 (GND), D708.8 (GND), D709.2 (A), D711.1 (C), D712.2 (A), H701.1, J701.1, J701.2, J701.7, J701.13, J701.14, J701.19, J701.25, J701.31, J701.32, J701.MP, J702.2 (D2S), J702.5 (D1S), J702.8 (D0S), J702.11 (CKS), J702.17 (GND), J702.SH
HDMI.CEC: D708.2 (CH2), D708.9 (CH2), R701.3 (R3.1)
HDMI.CLK_N: D707.5 (CH4), D707.6 (CH4), J702.12 (CK-)
HDMI.CLK_P: D707.4 (CH3), D707.7 (CH3), J702.10 (CK+)
HDMI.D0_N: D707.2 (CH2), D707.9 (CH2), J702.9 (D0-)
HDMI.D0_P: D707.1 (CH1), D707.10 (CH1), J702.7 (D0+)
HDMI.D1_N: D706.5 (CH4), D706.6 (CH4), J702.6 (D1-)
HDMI.D1_P: D706.4 (CH3), D706.7 (CH3), J702.4 (D1+)
HDMI.D2_N: D706.2 (CH2), D706.9 (CH2), J702.3 (D2-)
HDMI.D2_P: D706.1 (CH1), D706.10 (CH1), J702.1 (D2+)
HDMI.HPD: D708.1 (CH1), D708.10 (CH1), R701.4 (R4.1)
HDMI.SCL: D708.4 (CH3), D708.7 (CH3), R701.2 (R2.1)
HDMI.SDA: D708.5 (CH4), D708.6 (CH4), R701.1 (R1.1)
HPD: J702.19 (HPD/HEAC-), R701.5 (R4.2)
I_{2}C1.SCL: D704.2 (CH2), D704.9 (CH2), R705.7 (R2.2)
I_{2}C1.SDA: D704.1 (CH1), D704.10 (CH1), R705.8 (R1.2)
unnamed: C701.2, D709.1 (C), FB702.2, J701.4, J701.6, J701.8, J701.10
unnamed: C702.2, D710.1 (C), D712.1 (C), J702.18 (+5V)
unnamed: D710.2 (A), FB701.2
unnamed: J701.16, R705.1 (R1.1)
unnamed: J701.18, R705.2 (R2.1)
unnamed: J701.20, R705.3 (R3.1)
unnamed: J701.22, R705.4 (R4.1)
unnamed: J701.24, R706.1 (R1.1)
unnamed: J701.26, R706.2 (R2.1)
unnamed: J701.28, R706.3 (R3.1)
unnamed: J701.30, R706.4 (R4.1)
SCL: J702.15 (SCL), R701.7 (R2.2)
SDA: J702.16 (SDA), R701.8 (R1.2)

Notes on the sheet:
HDMI Connector
Antmicro CM4 Baseboard DSI Connector
