antmicro/cm4-baseboard/ethernet.kicad_sch

## KiCad design ethernet.kicad_sch (2024-09-13)

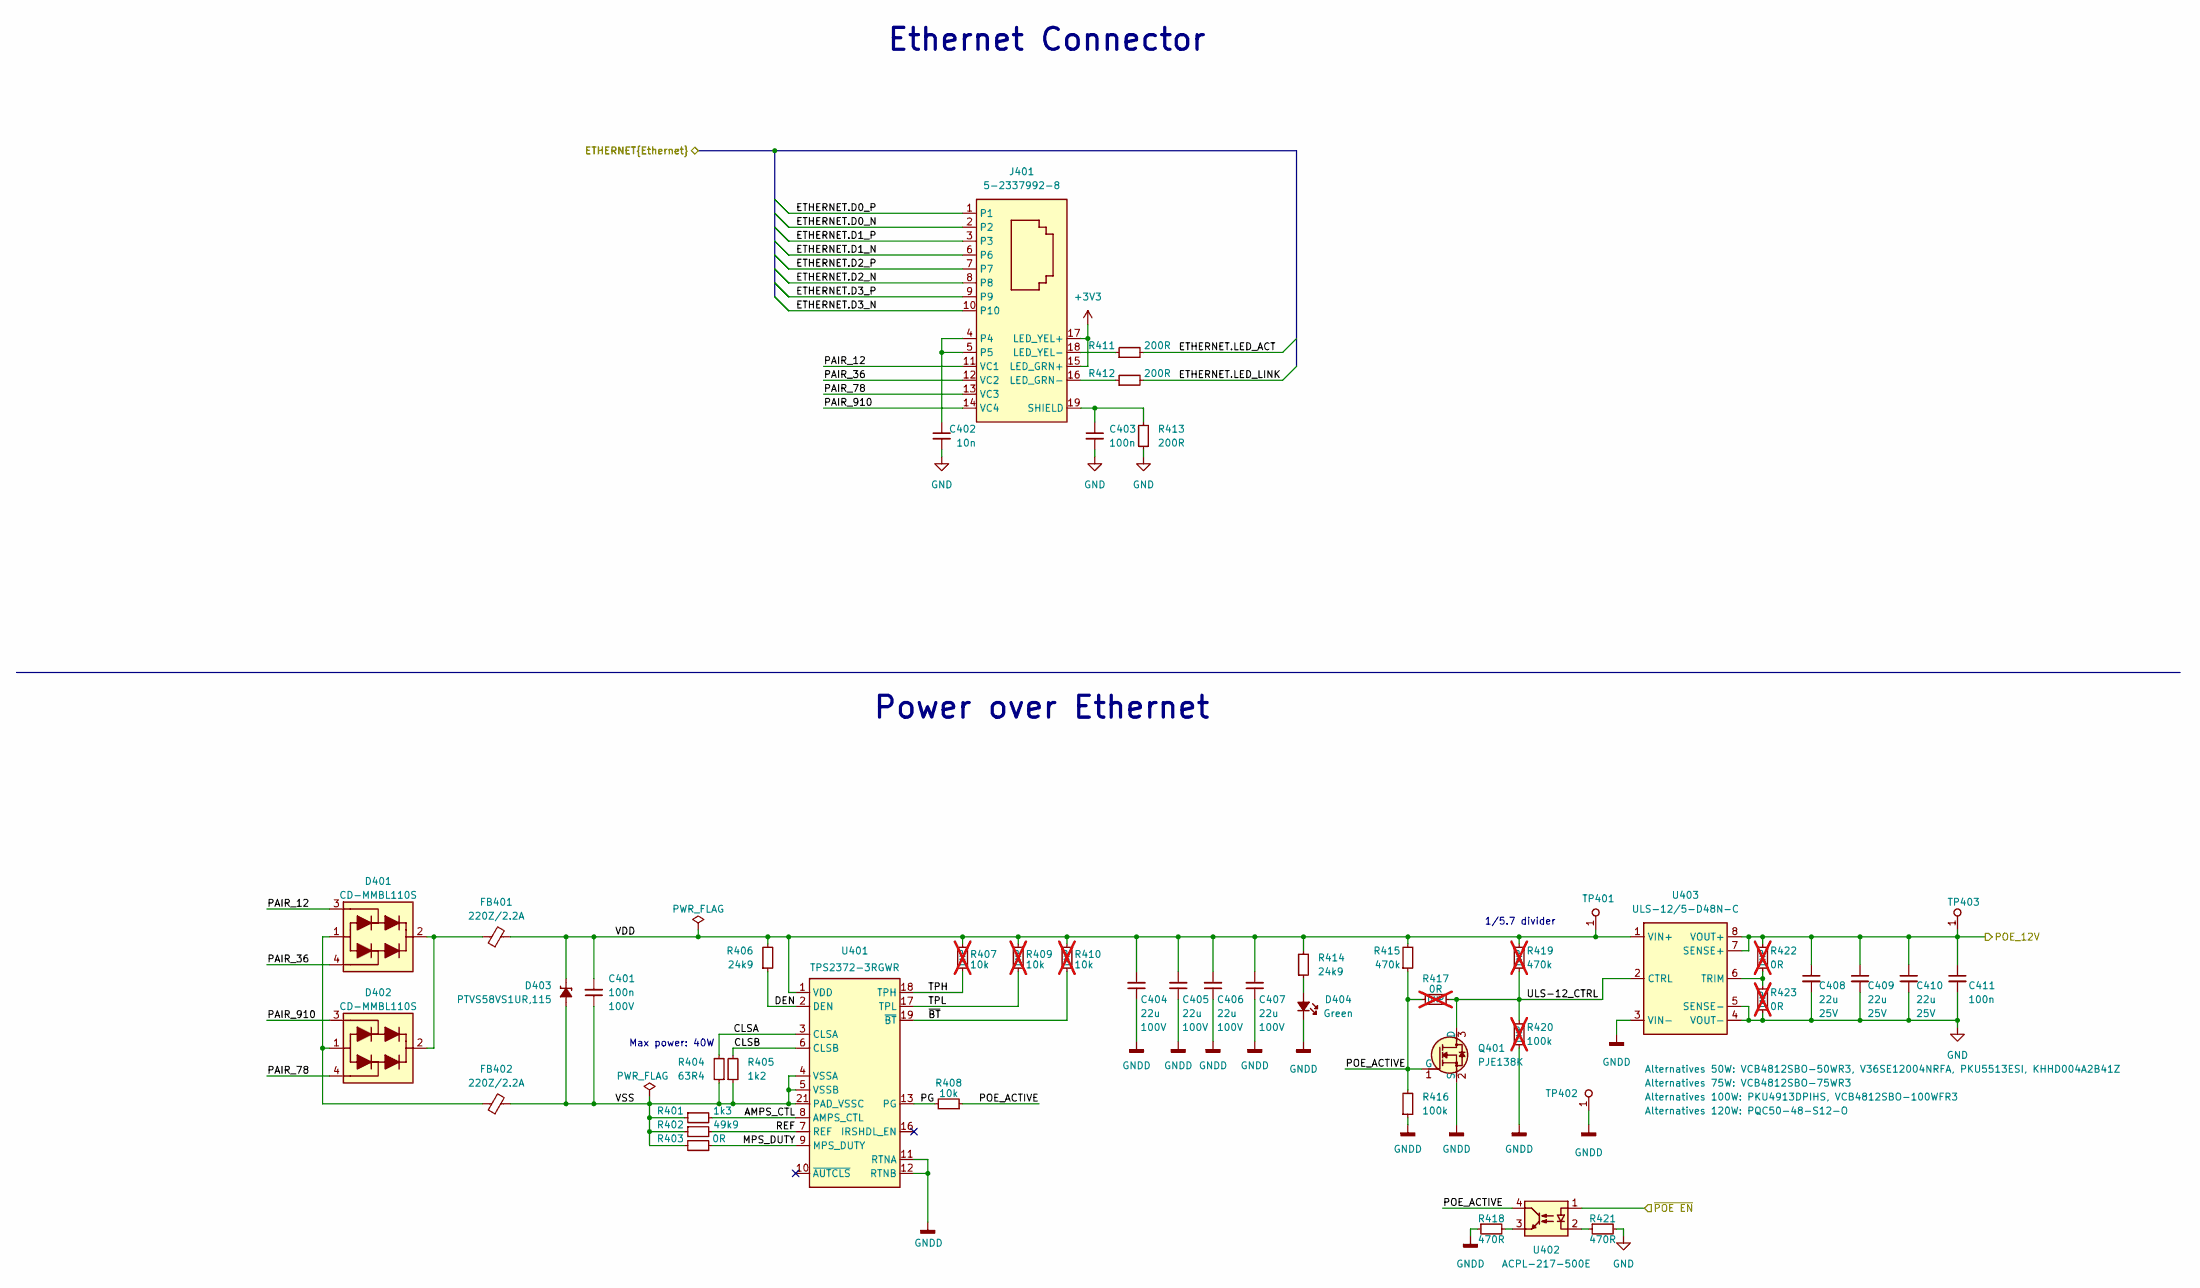
[picture p25: schematic ethernet.kicad_sch]

Parts:
C401: C_100n_100V_0805; C_0805_2012Metric; Voltage 100V; MPN CL21B104KCFNNNE
C402: C_10n_0402; C_0402_1005Metric; Voltage 50V; MPN GRM155R71H103KA88D
C403, C411: C_100n_0402; C_0402_1005Metric; Voltage 50V; MPN GRM155R61H104KE14D
C404, C405, C406, C407: C_22u_100V_2220; C_2220_5650Metric; Voltage 100V; MPN C5750X7S2A226M280KB
C408, C409, C410: C_22u_25V_0805; C_0805_2012Metric; Voltage 25V; MPN CL21A226MAYNNNE
D401, D402: CD-MMBL110S; DFN3538; MPN CD-MMBL110S
D403: PTVS58VS1UR,115; D_SOD-123F; MPN PTVS58VS1UR,115
D404: LED_G_0603_KP-1608CGCK; LED_0603_1608Metric_G; MPN KP-1608CGCK
FB401, FB402: FB_220Z_2.2A_TDK-MPZ_0603; FB_0603_1608Metric; MPN MPZ1608S221ATA00
J401: Bus_RJ45_5-2337992-8; RJ45_X-2337992-8_Horizontal; MPN 5-2337992-8
Q401: PJE138K; SOT-523; MPN PJE138K_R1_00001
R401: R_1k3_0402; R_0402_1005Metric; Tolerance 1%; MPN CR0402-FX-1301GLF
R402: R_49k9_0402; R_0402_1005Metric; Tolerance 1%; MPN CR0402-FX-4992GLF
R403: R_0R_0402; R_0402_1005Metric; MPN ERJ2GE0R00X
R404: R_63R4_0603; R_0603_1608Metric; Tolerance 1%; MPN CR0603-FX-63R4ELF
R405: R_1k2_0402; R_0402_1005Metric; Tolerance 1%; MPN CR0402-FX-1201GLF
R406, R414: R_24k9_0402; R_0402_1005Metric; Tolerance 1%; MPN CR0402-FX-2492GLF
R407, R409, R410: R_10k_0402; R_0402_1005Metric; Tolerance 1%; MPN CR0402-FX-1002GLF; not fitted
R408: R_10k_0402; R_0402_1005Metric; Tolerance 1%; MPN CR0402-FX-1002GLF
R411, R412, R413: R_200R_0402; R_0402_1005Metric; Tolerance 1%; MPN CR0402-FX-2000GLF
R415: R_470k_0402; R_0402_1005Metric; Tolerance 1%; MPN CR0402-FX-4703GLF
R416: R_100k_0402; R_0402_1005Metric; Tolerance 1%; MPN CR0402-FX-1003GLF
R417, R422, R423: R_0R_0402; R_0402_1005Metric; MPN ERJ2GE0R00X; not fitted
R418, R421: R_470R_0402; R_0402_1005Metric; Tolerance 1%; MPN CR0402-FX-4700GLF
R419: R_470k_0402; R_0402_1005Metric; Tolerance 1%; MPN CR0402-FX-4703GLF; not fitted
R420: R_100k_0402; R_0402_1005Metric; Tolerance 1%; MPN CR0402-FX-1003GLF; not fitted
TP401, TP402, TP403: TP_0.75mm_SMD; TP_SMD_0.75mm
U401: TPS2372-3RGWR; VQFN-20_5x5x1mm_P0.65mm; MPN TPS2372-3RGWR
U402: ACPL-217-500E; SOIC-4_4.55x2.6mm_P1.27mm; MPN ACPL-217-500E
U403: ULS-12_5-D48N-C; MPN ULS-12/5-D48N-C

Connections:
+3V3: J401.15 (LED_GRN+), J401.17 (LED_YEL+)
AMPS_CTL: R401.2, U401.8 (AMPS_CTL)
CLSA: R404.2, U401.3 (CLSA)
CLSB: R405.2, U401.6 (CLSB)
DEN: R406.1, U401.2 (DEN)
ETHERNET.D0_N: J401.2
ETHERNET.D0_P: J401.1
ETHERNET.D1_N: J401.6
ETHERNET.D1_P: J401.3
ETHERNET.D2_N: J401.8
ETHERNET.D2_P: J401.7
ETHERNET.D3_N: J401.10
ETHERNET.D3_P: J401.9
ETHERNET.LED_ACT: R411.2
ETHERNET.LED_LINK: R412.2
GND: C402.2, C403.2, C408.2, C409.2, C410.2, C411.2, R413.1, R421.2, R423.2, U403.4 (VOUT-), U403.5 (SENSE-)
GNDD: C404.1, C405.1, C406.1, C407.1, D404.1 (C), Q401.2 (S), R416.1, R418.1, R420.1, TP402.1, U401.11 (RTNA), U401.12 (RTNB), U403.3 (VIN-)
MPS_DUTY: R403.1, U401.9 (MPS_DUTY)
unnamed: C402.1, J401.4, J401.5
unnamed: C403.1, J401.19 (SHIELD), J401.20 (SHIELD), R413.2
unnamed: D401.1, D402.1, FB402.1
unnamed: D401.2, D402.2, FB401.1
unnamed: D404.2 (A), R414.1
unnamed: J401.16 (LED_GRN-), R412.1
unnamed: J401.18 (LED_YEL-), R411.1
unnamed: R418.2, U402.3
unnamed: R421.1, U402.2
unnamed: R422.2, R423.1, U403.6 (TRIM)
PAIR_12: D401.3, J401.11 (VC1)
PAIR_36: D401.4, J401.12 (VC2)
PAIR_78: D402.4, J401.13 (VC3)
PAIR_910: D402.3, J401.14 (VC4)
PG: R408.2, U401.13 (PG)
POE_12V: C408.1, C409.1, C410.1, C411.1, R422.1, TP403.1, U403.7 (SENSE+), U403.8 (VOUT+)
POE_ACTIVE: Q401.1 (G), R408.1, R415.1, R416.2, R417.2, U402.4
REF: R402.2, U401.7 (REF)
TPH: R407.1, U401.18 (TPH)
TPL: R409.1, U401.17 (TPL)
ULS-12_CTRL: Q401.3 (D), R417.1, R419.1, R420.2, U403.2 (CTRL)
VDD: C401.2, C404.2, C405.2, C406.2, C407.2, D403.1 (C), FB401.2, R406.2, R407.2, R409.2, R410.2, R414.2, R415.2, R419.2, TP401.1, U401.1 (VDD), U403.1 (VIN+)
VSS: C401.1, D403.2 (A), FB402.2, R401.1, R402.1, R403.2, R404.1, R405.1, U401.4 (VSSA), U401.5 (VSSB), U401.21 (PAD_VSSC)
~BT: R410.1, U401.19 (~BT)
~POE EN: U402.1

Notes on the sheet:
Ethernet Connector
1/5.7 divider
Max power: 40W
Power over Ethernet
