antmicro/cm4-baseboard/nvme-micro-sd.kicad_sch

## KiCad design nvme-micro-sd.kicad_sch (2024-09-13)

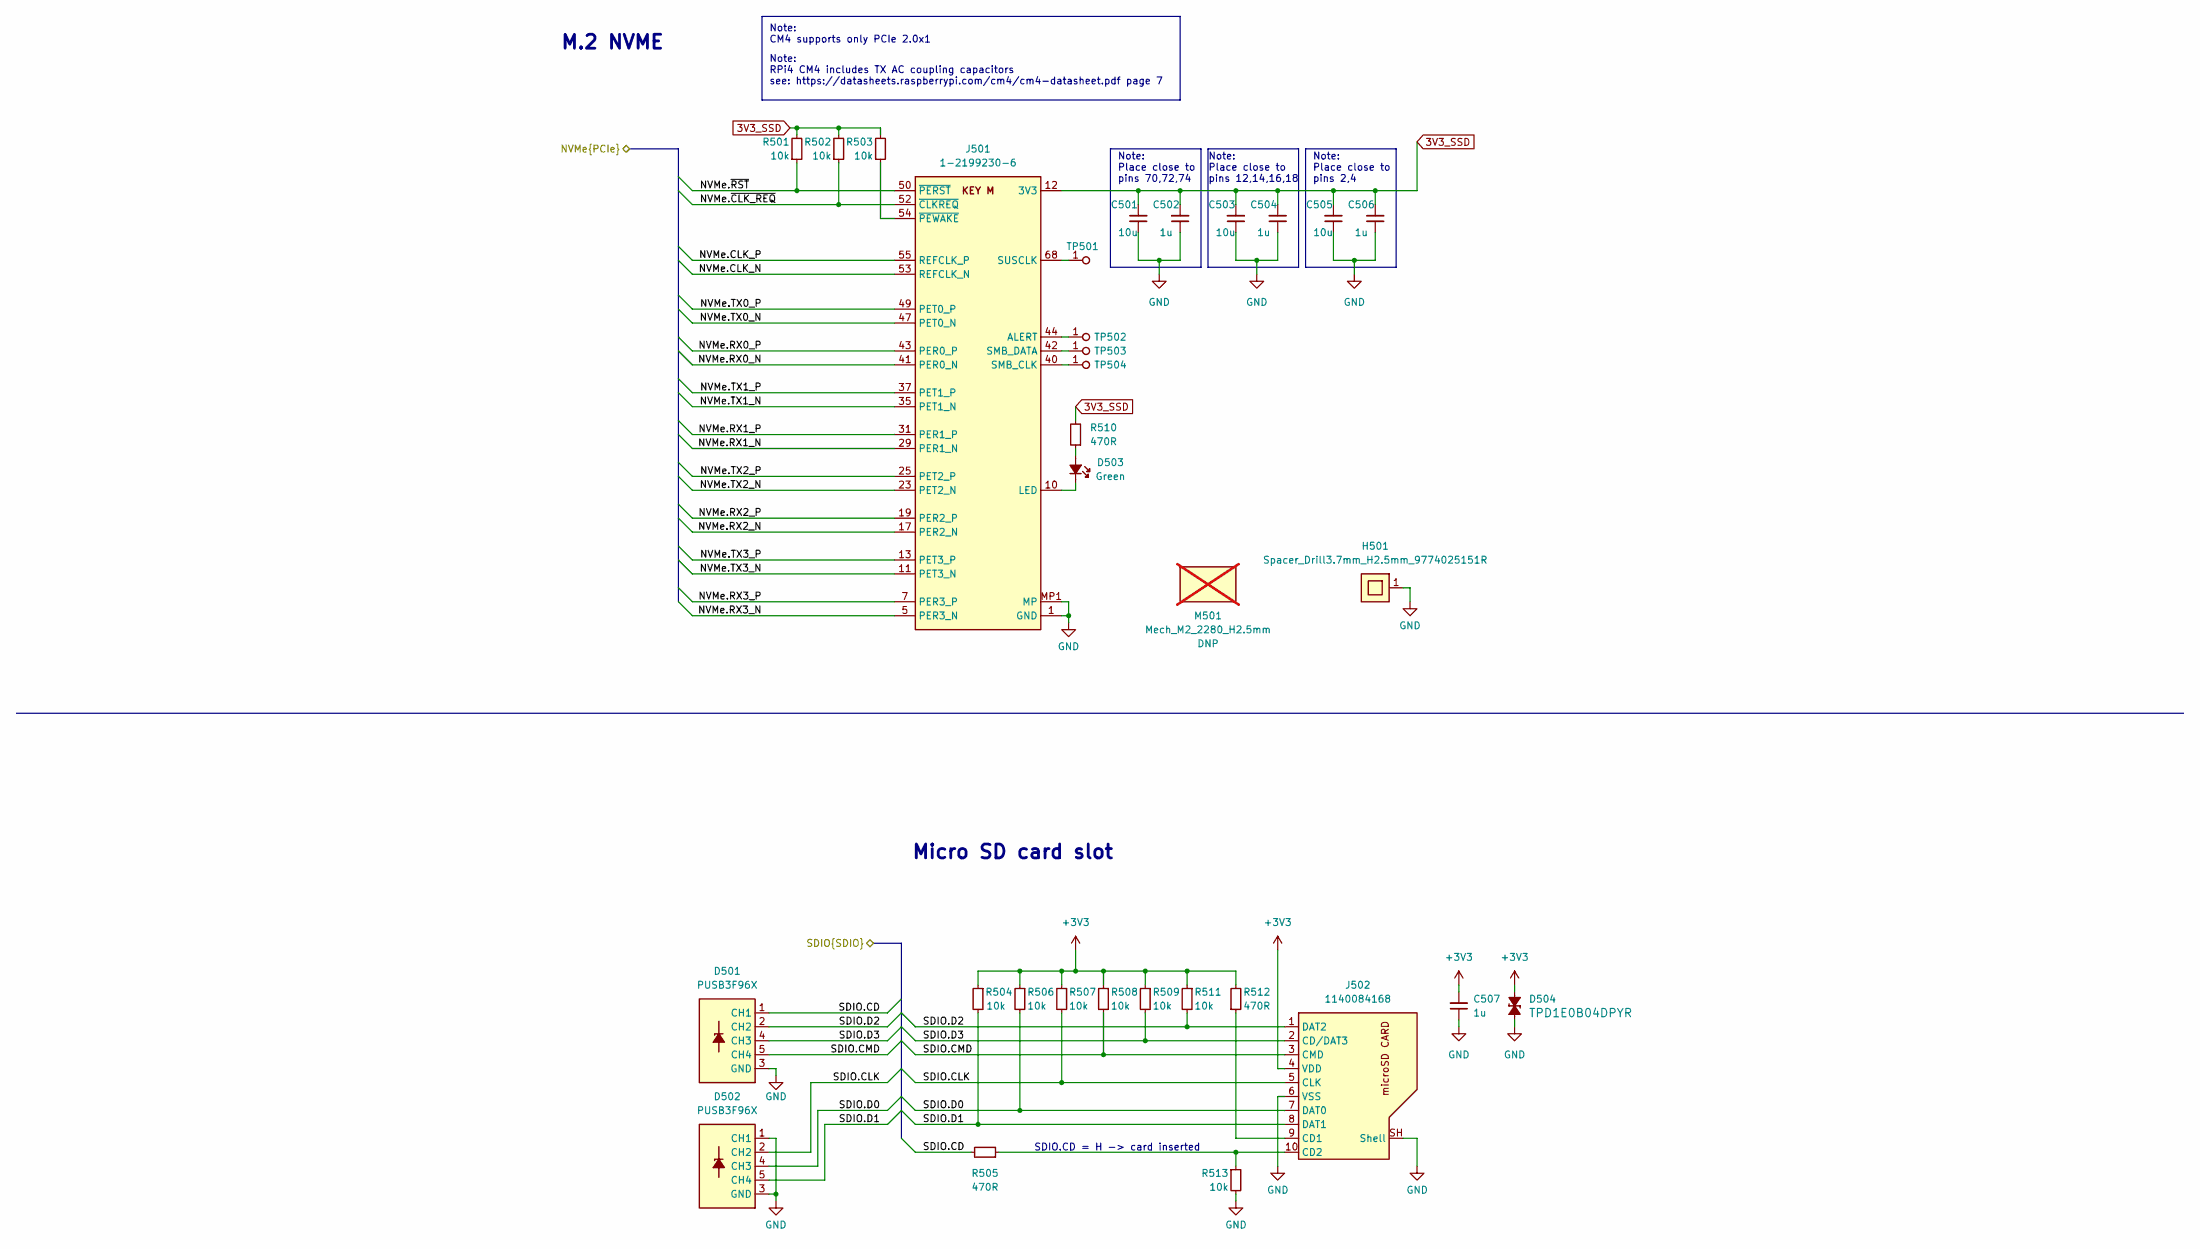
[picture p26: schematic nvme-micro-sd.kicad_sch]

Parts:
C501, C503, C505: C_10u_0402; C_0402_1005Metric; MPN CC0402MRX5R5BB106
C502, C504, C506, C507: C_1u_0402; C_0402_1005Metric; MPN C1005X6S1A105K050BC
D501, D502: PUSB3F96X_PASS; Nexperia_DFN-10_2.5x1mm_P0.5mm; MPN PUSB3F96X
D503: LED_G_0603_KP-1608CGCK; LED_0603_1608Metric_G; MPN KP-1608CGCK
D504: TPD1E0B04_XDFN-2; XDFN-2_1x0.60mm; MPN TPD1E0B04DPYR
H501: Spacer_Drill3.7mm_H2.5mm_9774025151R; MPN 9774025151R
J501: Bus_M.2_1-2199230-6; Bus_M.2_Socket_Key_M_TE_1-2199230-6; MPN 1-2199230-6
J502: MicroSD_1140084168; MicroSD_Amphenol_1140084168; MPN 1140084168
M501: Mech_M2_2280_H2.5mm; not fitted
R501, R502, R503, R504, R506, R507, R508, R509, R511, R513: R_10k_0402; R_0402_1005Metric; Tolerance 1%; MPN CR0402-FX-1002GLF
R505, R510, R512: R_470R_0402; R_0402_1005Metric; Tolerance 1%; MPN CR0402-FX-4700GLF
TP501, TP502, TP503, TP504: TP_0.75mm_SMD; TP_SMD_0.75mm

Connections:
3V3_SSD: C501.2, C502.2, C503.2, C504.2, C505.2, C506.2, J501.2 (3V3), J501.4 (3V3), J501.12 (3V3), J501.14 (3V3), J501.16 (3V3), J501.18 (3V3), J501.70 (3V3), J501.72 (3V3), J501.74 (3V3), R501.2, R502.2, R503.2, R510.2
+3V3: C507.2, D504.2 (A), J502.4 (VDD), R504.1, R506.1, R507.1, R508.1, R509.1, R511.1, R512.2
GND: C501.1, C502.1, C503.1, C504.1, C505.1, C506.1, C507.1, D501.3 (GND), D501.8 (GND), D502.1 (CH1), D502.3 (GND), D502.8 (GND), D502.10 (CH1), D504.1 (C), H501.1, J501.1 (GND), J501.3 (GND), J501.9 (GND), J501.15 (GND), J501.21 (GND), J501.27 (GND), J501.33 (GND), J501.39 (GND), J501.45 (GND), J501.51 (GND), J501.57 (GND), J501.71 (GND), J501.73 (GND), J501.75 (GND), J501.MP1 (MP), J501.MP2 (MP), J502.6 (VSS), J502.SH (Shell), R513.2
NVMe.CLK_N: J501.53 (REFCLK_N)
NVMe.CLK_P: J501.55 (REFCLK_P)
NVMe.RX0_N: J501.41 (PER0_N)
NVMe.RX0_P: J501.43 (PER0_P)
NVMe.RX1_N: J501.29 (PER1_N)
NVMe.RX1_P: J501.31 (PER1_P)
NVMe.RX2_N: J501.17 (PER2_N)
NVMe.RX2_P: J501.19 (PER2_P)
NVMe.RX3_N: J501.5 (PER3_N)
NVMe.RX3_P: J501.7 (PER3_P)
NVMe.TX0_N: J501.47 (PET0_N)
NVMe.TX0_P: J501.49 (PET0_P)
NVMe.TX1_N: J501.35 (PET1_N)
NVMe.TX1_P: J501.37 (PET1_P)
NVMe.TX2_N: J501.23 (PET2_N)
NVMe.TX2_P: J501.25 (PET2_P)
NVMe.TX3_N: J501.11 (PET3_N)
NVMe.TX3_P: J501.13 (PET3_P)
NVMe.~CLK_REQ: J501.52 (~CLKREQ), R502.1
NVMe.~RST: J501.50 (~PERST), R501.1
unnamed: D503.1 (C), J501.10 (LED)
unnamed: D503.2 (A), R510.1
unnamed: J501.40 (SMB_CLK), TP504.1
unnamed: J501.42 (SMB_DATA), TP503.1
unnamed: J501.44 (ALERT), TP502.1
unnamed: J501.54 (~PEWAKE), R503.1
unnamed: J501.68 (SUSCLK), TP501.1
unnamed: J502.9 (CD1), R512.1
unnamed: J502.10 (CD2), R505.1, R513.1
SDIO.CD: D501.1 (CH1), D501.10 (CH1), R505.2
SDIO.CLK: D502.2 (CH2), D502.9 (CH2), J502.5 (CLK), R507.2
SDIO.CMD: D501.5 (CH4), D501.6 (CH4), J502.3 (CMD), R508.2
SDIO.D0: D502.4 (CH3), D502.7 (CH3), J502.7 (DAT0), R506.2
SDIO.D1: D502.5 (CH4), D502.6 (CH4), J502.8 (DAT1), R504.2
SDIO.D2: D501.2 (CH2), D501.9 (CH2), J502.1 (DAT2), R511.2
SDIO.D3: D501.4 (CH3), D501.7 (CH3), J502.2 (CD/DAT3), R509.2

Notes on the sheet:
SDIO.CD = H -> card inserted
Note: CM4 supports only PCIe 2.0x1
Note: RPi4 CM4 includes TX AC coupling capacitors see: https://datasheets.raspberrypi.com/cm4/cm4-datasheet.pdf page 7
Note: Place close to pins 12,14,16,18
Note: Place close to pins 2,4
Micro SD card slot
Note: Place close to pins 70,72,74
M.2 NVME
