antmicro/cm4-baseboard/peripherals.kicad_sch

## KiCad design peripherals.kicad_sch (2024-09-13)

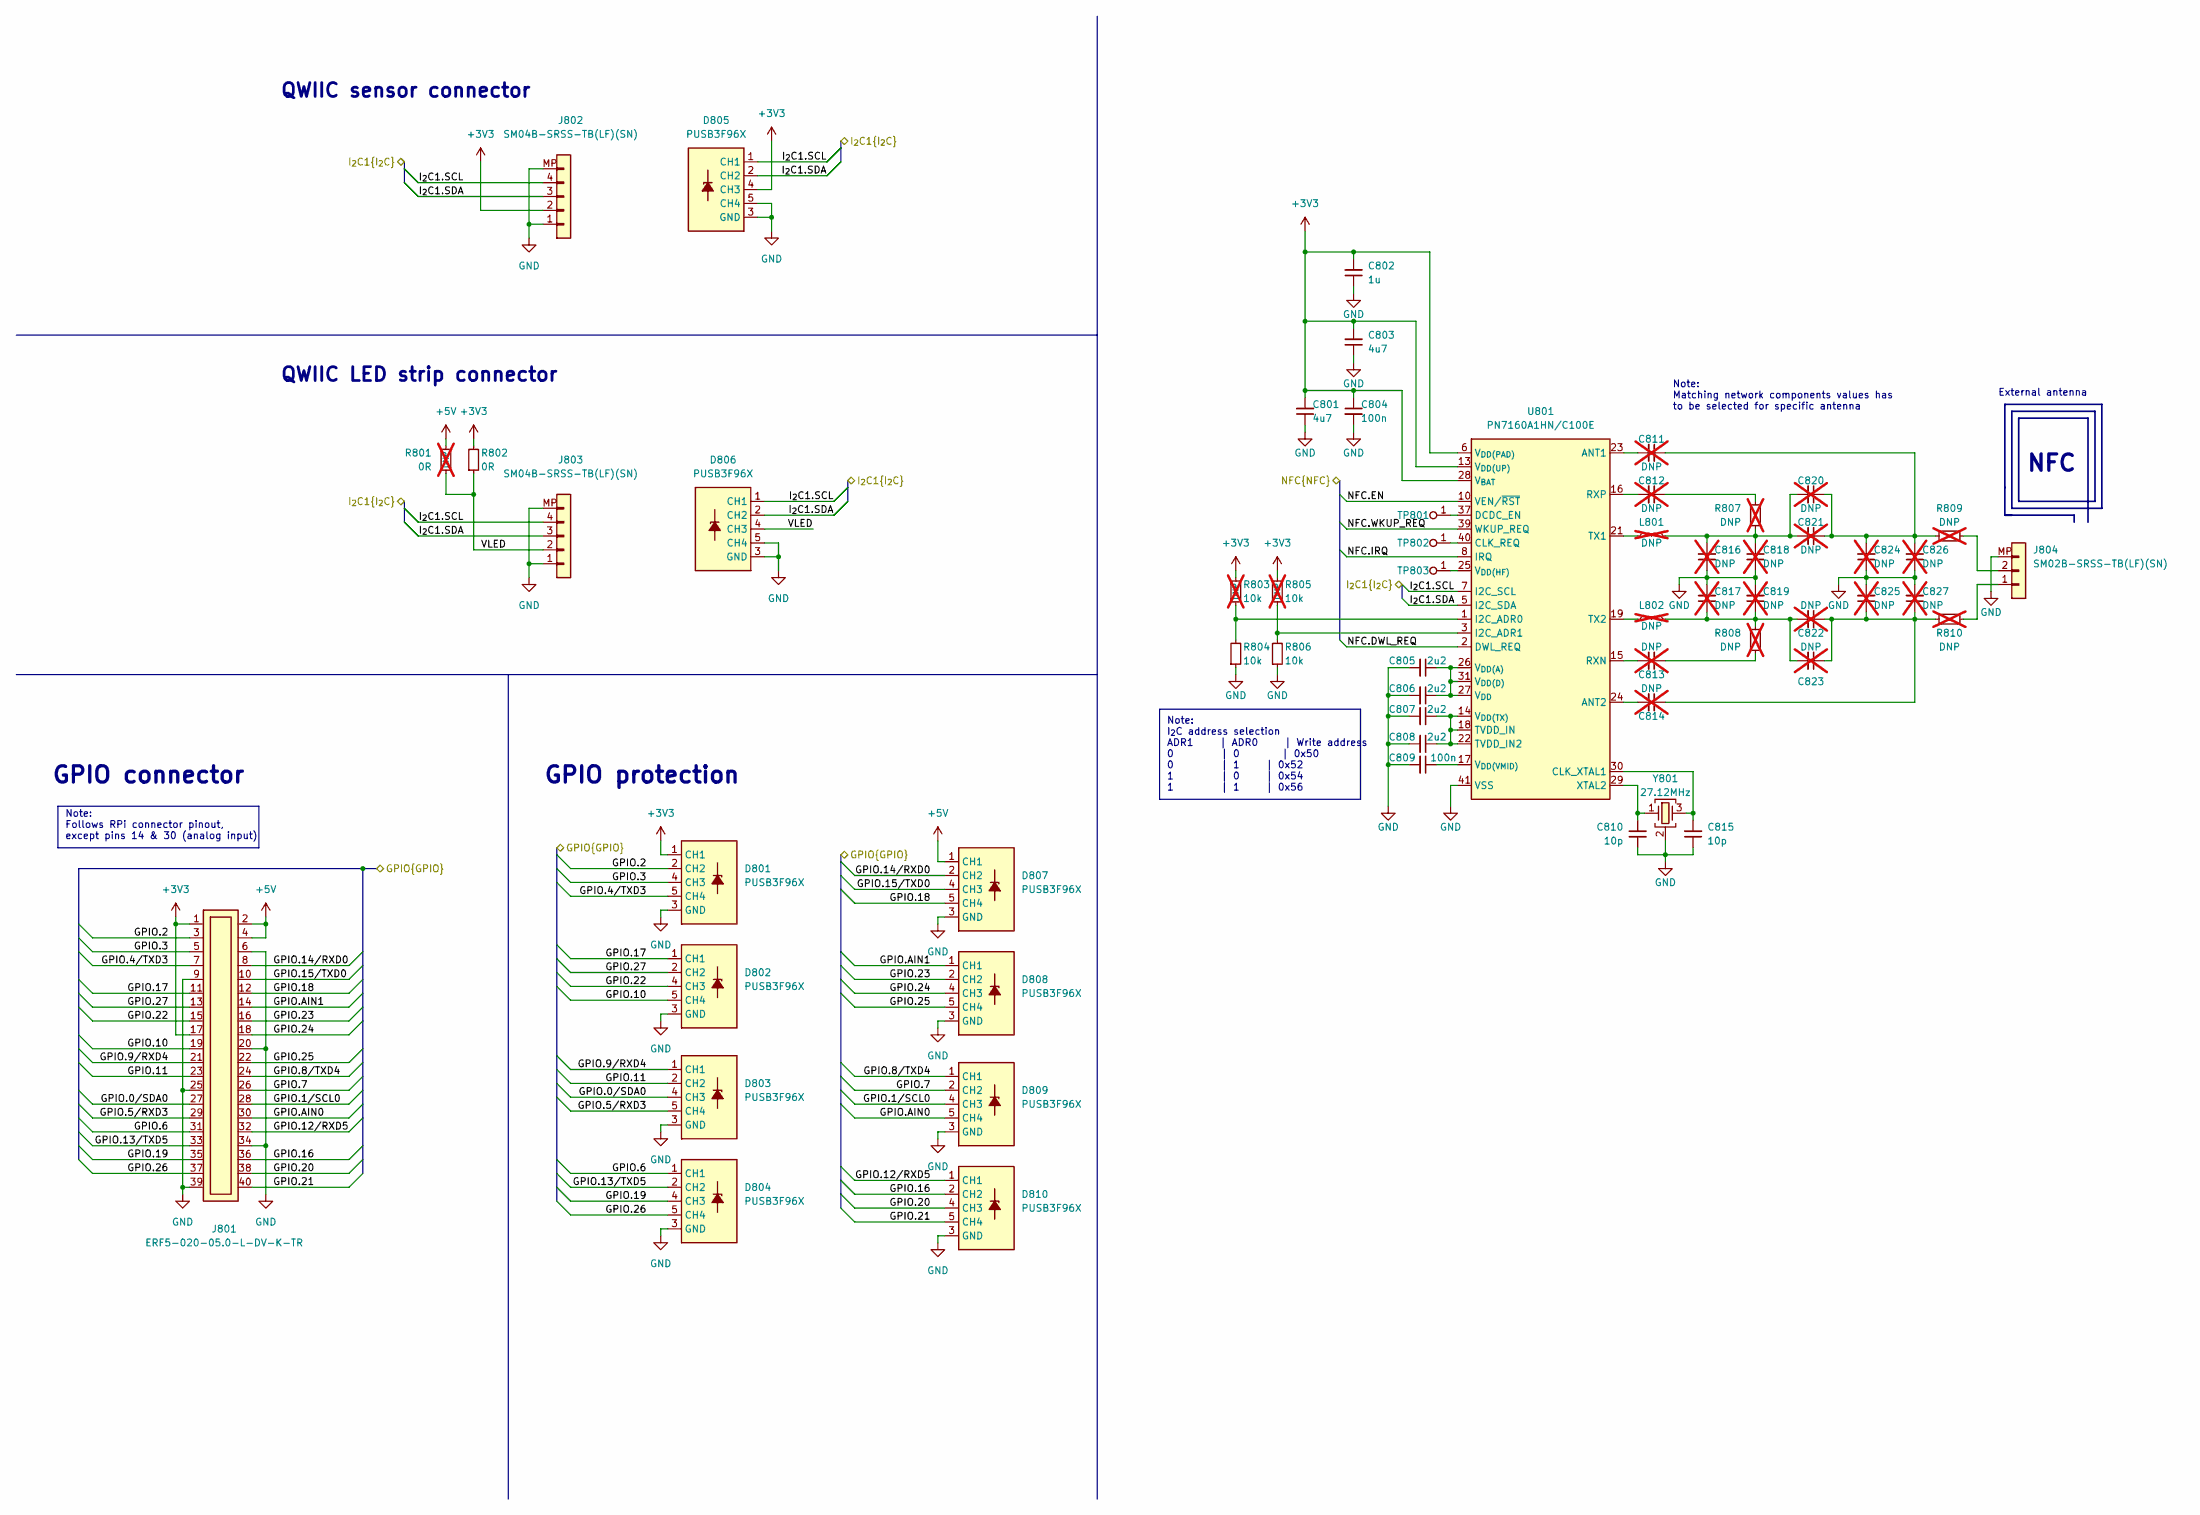
[picture p27: schematic peripherals.kicad_sch]

Parts:
C801, C803: C_4u7_0402; C_0402_1005Metric; MPN GRM155R61A475MEAAD
C802: C_1u_0402; C_0402_1005Metric; MPN C1005X6S1A105K050BC
C804, C809: C_100n_0402; C_0402_1005Metric; Voltage 50V; MPN GRM155R61H104KE14D
C805, C806, C807, C808: C_2u2_0402; C_0402_1005Metric; MPN C1005X5R1A225K050BC
C810, C815: C_10p_0402; C_0402_1005Metric; Voltage 50V; MPN GCM1555C1H100GA16D
C811, C812, C813, C814, C816, C817, C818, C819, C820, C821, C822, C823, C824, C825, C826, C827: C_template_name_0402; C_0402_1005Metric; Voltage template_voltage; MPN template_MPN; not fitted
D801, D802, D803, D804, D805, D806, D807, D808, D809, D810: PUSB3F96X_PASS; Nexperia_DFN-10_2.5x1mm_P0.5mm; MPN PUSB3F96X
J801: Socket_Samtec_ERF5_2x20_ERF5-020-05.0-L-DV-K-TR; Conn_Socket_Samtec_ERF5_2x20_ERF5-020-05.0-L-DV-K-TR; MPN ERF5-020-05.0-L-DV-K-TR
J802, J803: JST_SH_1x4_SM04B-SRSS-TB-LF-SN; Conn_JST_SH_1x4_SM04B-SRSS-TB-LF-SN; MPN SM04B-SRSS-TB(LF)(SN)
J804: JST_SH_1x2_SM02B-SRSS-TB-LF-SN; Conn_JST_SH_1x2_SM02B-SRSS-TB-LF-SN; MPN SM02B-SRSS-TB(LF)(SN)
L801, L802: L_template_name; not fitted
R801: R_0R_0402; R_0402_1005Metric; MPN ERJ2GE0R00X; not fitted
R802: R_0R_0402; R_0402_1005Metric; MPN ERJ2GE0R00X
R803, R805: R_10k_0402; R_0402_1005Metric; Tolerance 1%; MPN CR0402-FX-1002GLF; not fitted
R804, R806: R_10k_0402; R_0402_1005Metric; Tolerance 1%; MPN CR0402-FX-1002GLF
R807, R808, R809, R810: R_template_name_0402; R_0402_1005Metric; Tolerance template_tolerance; MPN template_MPN; not fitted
TP801, TP802, TP803: TP_0.75mm_SMD; TP_SMD_0.75mm
U801: PN7160A1_VFQFN; VFQFN-40-1EP_6x6mm; MPN PN7160A1HN/C100E
Y801: Resonator_27.12MHz_XRCGB; Resonator_SMD_Murata_XRCGB_2x1.6x0.65mm; MPN XRCGB27M120F3M13R0

Connections:
+3V3: C801.2, C802.2, C803.2, C804.1, D801.1 (CH1), D801.10 (CH1), D805.4 (CH3), D805.7 (CH3), J801.1, J801.17, J802.2, R802.2, R803.2, R805.2, U801.6 (V_{DD(PAD)}), U801.12 (V_{BAT}), U801.13 (V_{DD(UP)}), U801.28 (V_{BAT})
+5V: D807.1 (CH1), D807.10 (CH1), J801.2, J801.4, R801.2
GND: C801.1, C802.1, C803.1, C804.2, C805.2, C806.2, C807.2, C808.2, C809.2, C810.1, C815.1, C816.1, C817.2, C818.1, C819.2, C824.1, C825.2, C826.1, C827.2, D801.3 (GND), D801.8 (GND), D802.3 (GND), D802.8 (GND), D803.3 (GND), D803.8 (GND), D804.3 (GND), D804.8 (GND), D805.3 (GND), D805.5 (CH4), D805.6 (CH4), D805.8 (GND), D806.3 (GND), D806.5 (CH4), D806.6 (CH4), D806.8 (GND), D807.3 (GND), D807.8 (GND), D808.3 (GND), D808.8 (GND), D809.3 (GND), D809.8 (GND), D810.3 (GND), D810.8 (GND), J801.6, J801.9, J801.20, J801.25, J801.34, J801.39, J802.1, J802.MP, J803.1, J803.MP, J804.MP, R804.1, R806.1, U801.4 (VSS), U801.9 (VSS), U801.20 (VSS), U801.41 (VSS), Y801.2 (SH), Y801.4 (SH)
GPIO.0/SDA0: D803.4 (CH3), D803.7 (CH3), J801.27
GPIO.1/SCL0: D809.4 (CH3), D809.7 (CH3), J801.28
GPIO.2: D801.2 (CH2), D801.9 (CH2), J801.3
GPIO.3: D801.4 (CH3), D801.7 (CH3), J801.5
GPIO.4/TXD3: D801.5 (CH4), D801.6 (CH4), J801.7
GPIO.5/RXD3: D803.5 (CH4), D803.6 (CH4), J801.29
GPIO.6: D804.1 (CH1), D804.10 (CH1), J801.31
GPIO.7: D809.2 (CH2), D809.9 (CH2), J801.26
GPIO.8/TXD4: D809.1 (CH1), D809.10 (CH1), J801.24
GPIO.9/RXD4: D803.1 (CH1), D803.10 (CH1), J801.21
GPIO.10: D802.5 (CH4), D802.6 (CH4), J801.19
GPIO.11: D803.2 (CH2), D803.9 (CH2), J801.23
GPIO.12/RXD5: D810.1 (CH1), D810.10 (CH1), J801.32
GPIO.13/TXD5: D804.2 (CH2), D804.9 (CH2), J801.33
GPIO.14/RXD0: D807.2 (CH2), D807.9 (CH2), J801.8
GPIO.15/TXD0: D807.4 (CH3), D807.7 (CH3), J801.10
GPIO.16: D810.2 (CH2), D810.9 (CH2), J801.36
GPIO.17: D802.1 (CH1), D802.10 (CH1), J801.11
GPIO.18: D807.5 (CH4), D807.6 (CH4), J801.12
GPIO.19: D804.4 (CH3), D804.7 (CH3), J801.35
GPIO.20: D810.4 (CH3), D810.7 (CH3), J801.38
GPIO.21: D810.5 (CH4), D810.6 (CH4), J801.40
GPIO.22: D802.4 (CH3), D802.7 (CH3), J801.15
GPIO.23: D808.2 (CH2), D808.9 (CH2), J801.16
GPIO.24: D808.4 (CH3), D808.7 (CH3), J801.18
GPIO.25: D808.5 (CH4), D808.6 (CH4), J801.22
GPIO.26: D804.5 (CH4), D804.6 (CH4), J801.37
GPIO.27: D802.2 (CH2), D802.9 (CH2), J801.13
GPIO.AIN0: D809.5 (CH4), D809.6 (CH4), J801.30
GPIO.AIN1: D808.1 (CH1), D808.10 (CH1), J801.14
I_{2}C1.SCL: D805.1 (CH1), D805.10 (CH1), D806.1 (CH1), D806.10 (CH1), J802.4, J803.4, U801.7 (I2C_SCL)
I_{2}C1.SDA: D805.2 (CH2), D805.9 (CH2), D806.2 (CH2), D806.9 (CH2), J802.3, J803.3, U801.5 (I2C_SDA)
NFC.DWL_REQ: U801.2 (DWL_REQ)
NFC.EN: U801.10 (VEN/~RST)
NFC.IRQ: U801.8 (IRQ)
NFC.WKUP_REQ: U801.39 (WKUP_REQ)
unnamed: C805.1, C806.1, U801.26 (V_{DD(A)}), U801.27 (V_{DD}), U801.31 (V_{DD(D)})
unnamed: C807.1, C808.1, U801.14 (V_{DD(TX)}), U801.18 (TVDD_IN), U801.22 (TVDD_IN2)
unnamed: C809.1, U801.17 (V_{DD(VMID)})
unnamed: C810.2, U801.29 (XTAL2), Y801.1
unnamed: C811.1, C820.1, C821.1, C824.2, C826.2, R809.2
unnamed: C811.2, U801.23 (ANT1)
unnamed: C812.1, R807.2
unnamed: C812.2, U801.16 (RXP)
unnamed: C813.1, R808.2
unnamed: C813.2, U801.15 (RXN)
unnamed: C814.1, C822.1, C823.1, C825.1, C827.1, R810.2
unnamed: C814.2, U801.24 (ANT2)
unnamed: C815.2, U801.30 (CLK_XTAL1), Y801.3
unnamed: C816.2, C818.2, C820.2, C821.2, L801.2, R807.1
unnamed: C817.1, C819.1, C822.2, C823.2, L802.2, R808.1
unnamed: J804.1, R810.1
unnamed: J804.2, R809.1
unnamed: L801.1, U801.21 (TX1)
unnamed: L802.1, U801.19 (TX2)
unnamed: R803.1, R804.2, U801.1 (I2C_ADR0)
unnamed: R805.1, R806.2, U801.3 (I2C_ADR1)
unnamed: TP801.1, U801.37 (DCDC_EN)
unnamed: TP802.1, U801.40 (CLK_REQ)
unnamed: TP803.1, U801.25 (V_{DD(HF)})
VLED: D806.4 (CH3), D806.7 (CH3), J803.2, R801.1, R802.1

Notes on the sheet:
GPIO protection
External antenna
Note: I_{2}C address selection ADR1 | ADR0 | Write address 0 | 0 | 0x50 0 | 1 | 0x52 1 | 0 | 0x54 1 | 1 | 0x56
Note: Matching network components values has to be selected for specific antenna
GPIO connector
Note: Follows RPi connector pinout, except pins 14 & 30 (analog input)
QWIIC LED strip connector
QWIIC sensor connector
NFC
