antmicro/cm4-baseboard/supply.kicad_sch

## KiCad design supply.kicad_sch (2024-09-13)

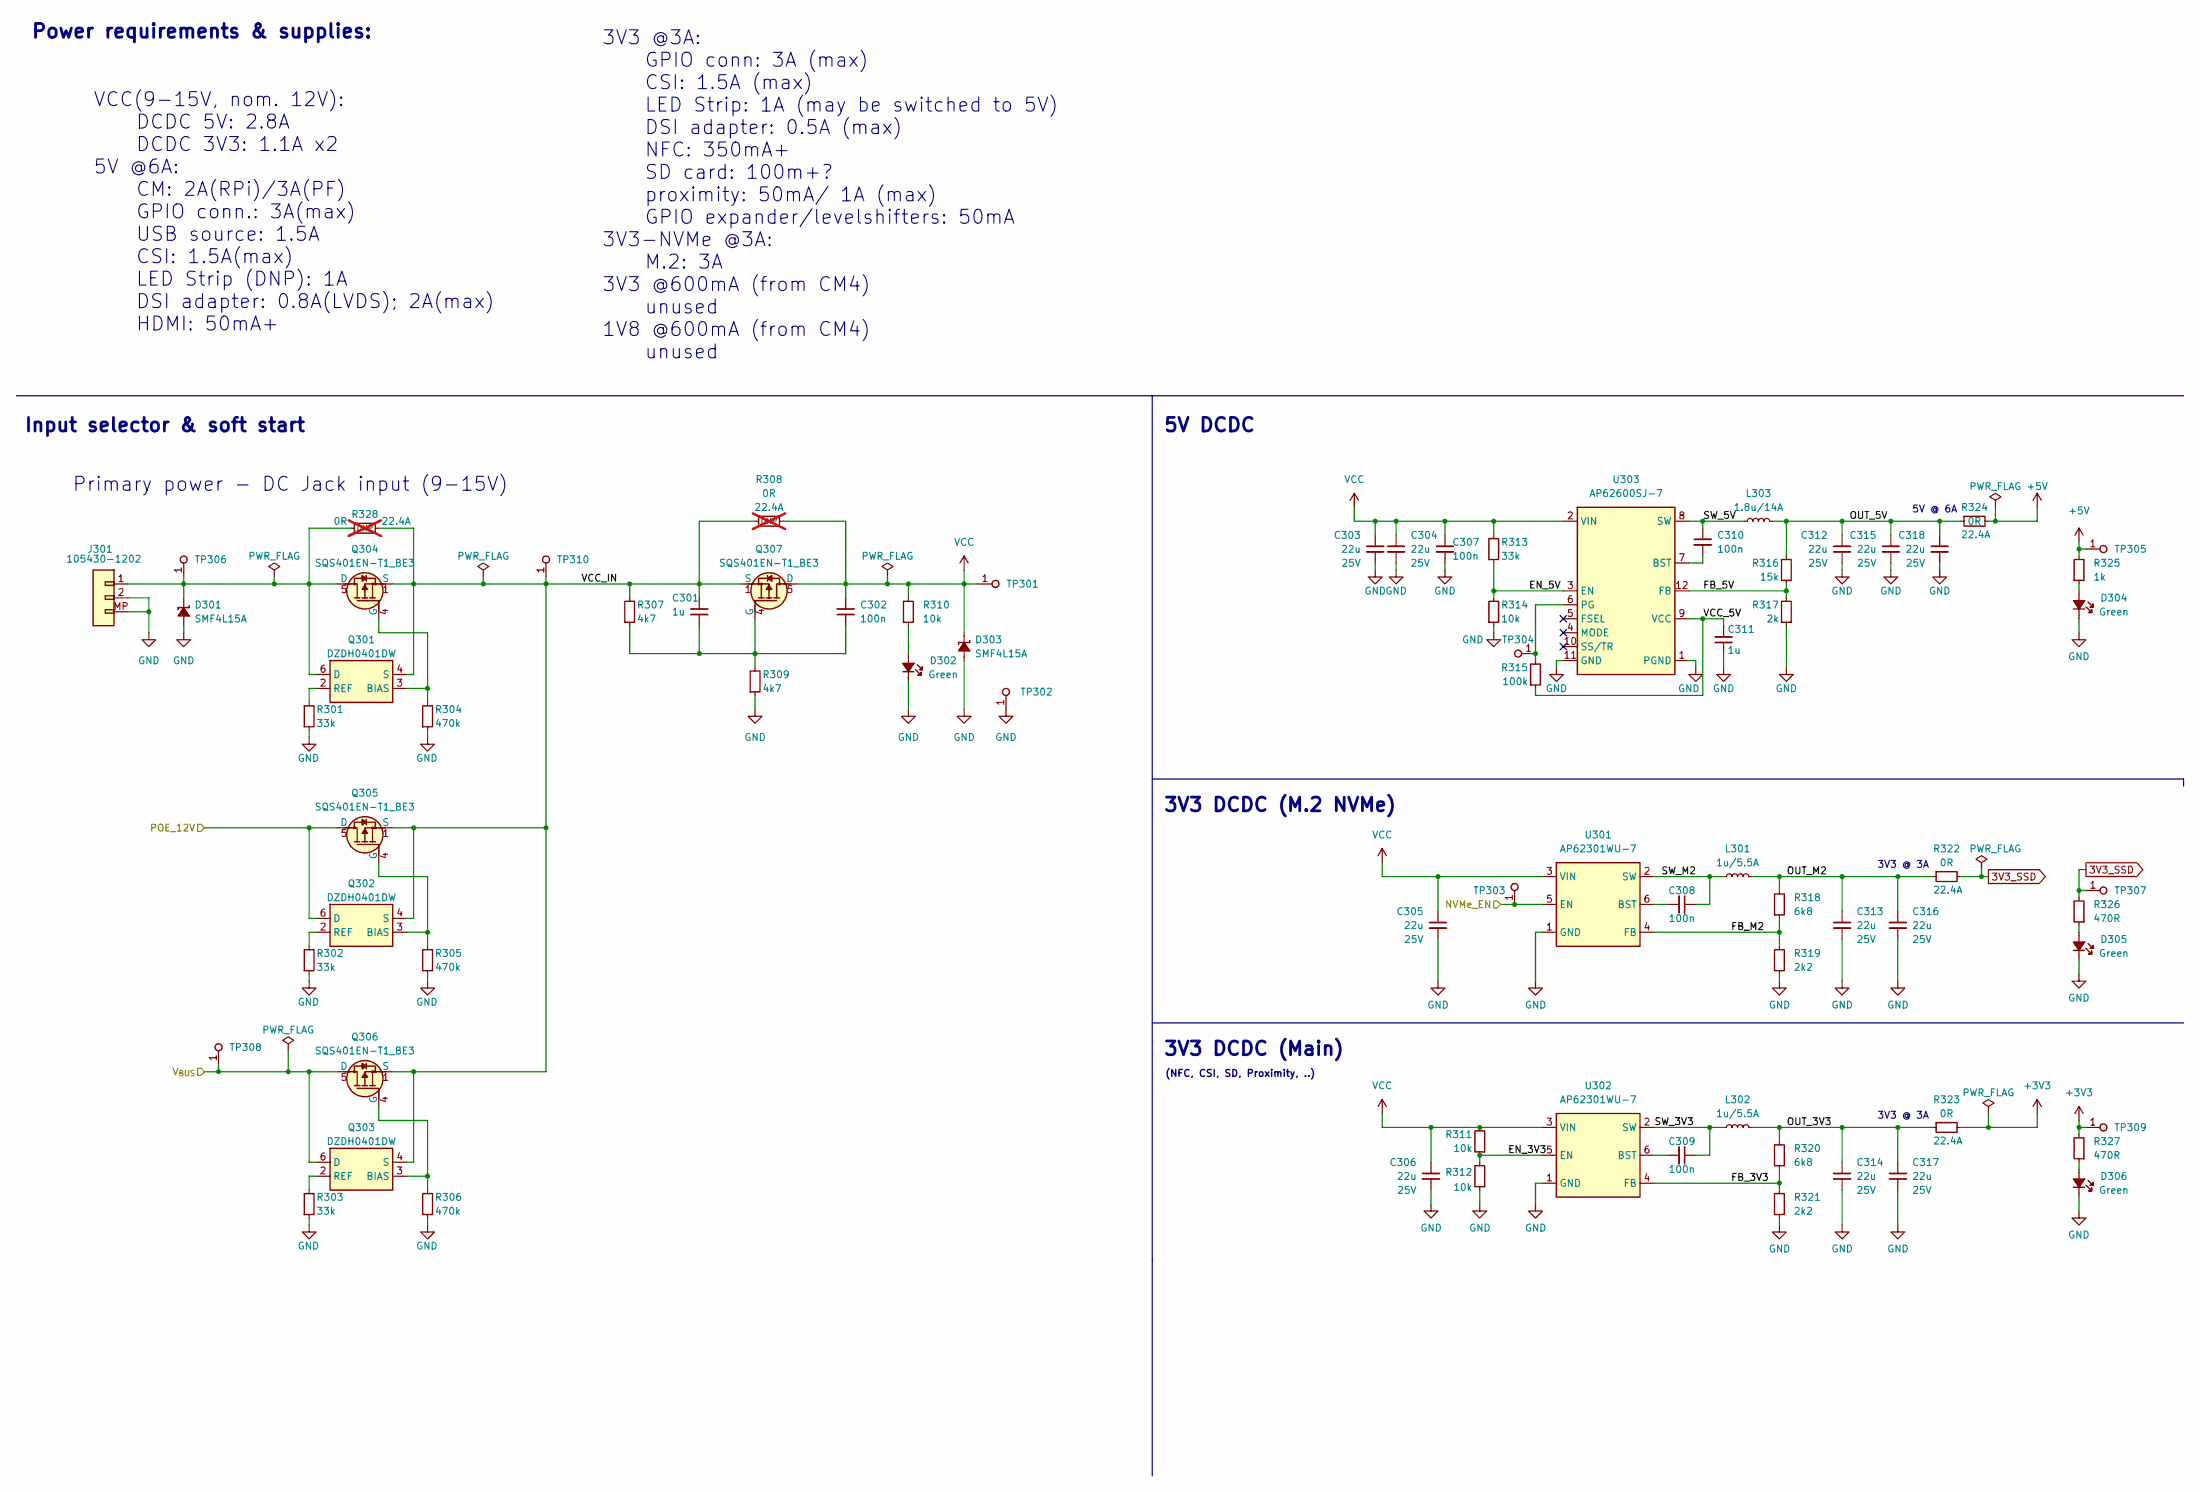
[picture p28: schematic supply.kicad_sch]

Parts:
C301: C_1u_25V_0402; C_0402_1005Metric; Voltage 25V; MPN GRM155R61E105KE11J
C302, C307, C308, C309, C310: C_100n_0402; C_0402_1005Metric; Voltage 50V; MPN GRM155R61H104KE14D
C303, C304, C305, C306, C312, C313, C314, C315, C316, C317, C318: C_22u_25V_0805; C_0805_2012Metric; Voltage 25V; MPN CL21A226MAYNNNE
C311: C_1u_0402; C_0402_1005Metric; MPN C1005X6S1A105K050BC
D301, D303: SMF4L15A; SOD-123FL; MPN SMF4L15A
D302, D304, D305, D306: LED_G_0603_KP-1608CGCK; LED_0603_1608Metric_G; MPN KP-1608CGCK
J301: Molex_Nano-Fit_1x2_SMD_1054301202; Conn_Molex_Nano-Fit_1x2_SMD_1054301202; MPN 105430-1202
L301, L302: L_1u_5.5A_Bourns-SRP3212A; L_Bourns-SRP3212A; MPN SRP3212A-1R0M
L303: L_1u8_14A_Coilcraft-XAL6030; L_Coilcraft-XAL6030; MPN XAL6030-182MEC
Q301, Q302, Q303: DZDH0401DW; SOT-363; MPN DZDH0401DW
Q304, Q305, Q306, Q307: SQS401EN-T1_BE3; Vishay_PowerPAK_1212-8_Single; MPN SQS401EN-T1_BE3
R301, R302, R303, R313: R_33k_0402; R_0402_1005Metric; Tolerance 1%; MPN CR0402-FX-3302GLF
R304, R305, R306: R_470k_0402; R_0402_1005Metric; Tolerance 1%; MPN CR0402-FX-4703GLF
R307, R309: R_4k7_0402; R_0402_1005Metric; Tolerance 1%; MPN CR0402-FX-4701GLF
R308, R328: R_0R_22.4A_0603; R_0603_1608Metric; Tolerance template_tolerance; MPN PMR03EZPJ000; not fitted
R310, R311, R312, R314: R_10k_0402; R_0402_1005Metric; Tolerance 1%; MPN CR0402-FX-1002GLF
R315: R_100k_0402; R_0402_1005Metric; Tolerance 1%; MPN CR0402-FX-1003GLF
R316: R_15k_0402; R_0402_1005Metric; Tolerance 1%; MPN CR0402-FX-1502GLF
R317: R_2k_0402; R_0402_1005Metric; Tolerance 1%; MPN CR0402-FX-2001GLF
R318, R320: R_6k8_0402; R_0402_1005Metric; Tolerance 1%; MPN CR0402-FX-6801GLF
R319, R321: R_2k2_0402; R_0402_1005Metric; Tolerance 1%; MPN CR0402-FX-2201GLF
R322, R323, R324: R_0R_22.4A_0603; R_0603_1608Metric; Tolerance template_tolerance; MPN PMR03EZPJ000
R325: R_1k_0402; R_0402_1005Metric; Tolerance 1%; MPN CR0402-FX-1001GLF
R326, R327: R_470R_0402; R_0402_1005Metric; Tolerance 1%; MPN CR0402-FX-4700GLF
TP301, TP302, TP303, TP304, TP305, TP306, TP307, TP308, TP309, TP310: TP_0.75mm_SMD; TP_SMD_0.75mm
U301, U302: AP62301_TSOT; TSOT23-6; MPN AP62301WU-7
U303: AP62600SJ-7; V-QFN2030-12; MPN AP62600SJ-7

Connections:
3V3_SSD: R322.2, R326.2, TP307.1
+3V3: R323.2, R327.2, TP309.1
+5V: R324.2, R325.2, TP305.1
EN_3V3: R311.1, R312.2, U302.5 (EN)
EN_5V: R313.1, R314.2, U303.3 (EN)
FB_3V3: R320.1, R321.2, U302.4 (FB)
FB_5V: R316.1, R317.2, U303.12 (FB)
FB_M2: R318.1, R319.2, U301.4 (FB)
GND: C303.2, C304.2, C305.2, C306.2, C307.2, C311.1, C312.2, C313.2, C314.2, C315.2, C316.2, C317.2, C318.2, D301.2 (A), D302.1 (C), D303.2 (A), D304.1 (C), D305.1 (C), D306.1 (C), J301.2, J301.MP, R301.1, R302.1, R303.1, R304.1, R305.1, R306.1, R309.1, R312.1, R314.1, R317.1, R319.1, R321.1, TP302.1, U301.1 (GND), U302.1 (GND), U303.1 (PGND), U303.11 (GND)
NVMe_EN: TP303.1, U301.5 (EN)
unnamed: C301.1, C302.1, Q307.4 (G), R307.1, R309.2
unnamed: C308.2, U301.6 (BST)
unnamed: C309.2, U302.6 (BST)
unnamed: C310.2, U303.7 (BST)
unnamed: D301.1 (C), J301.1, Q301.6 (D), Q304.5 (D), R328.1, TP306.1
unnamed: D302.2 (A), R310.1
unnamed: D304.2 (A), R325.1
unnamed: D305.2 (A), R326.1
unnamed: D306.2 (A), R327.1
unnamed: Q301.2 (REF), R301.2
unnamed: Q301.3 (BIAS), Q304.4 (G), R304.2
unnamed: Q302.2 (REF), R302.2
unnamed: Q302.3 (BIAS), Q305.4 (G), R305.2
unnamed: Q303.2 (REF), R303.2
unnamed: Q303.3 (BIAS), Q306.4 (G), R306.2
unnamed: R315.2, TP304.1, U303.6 (PG)
OUT_3V3: C314.1, C317.1, L302.2, R320.2, R323.1
OUT_5V: C312.1, C315.1, C318.1, L303.2, R316.2, R324.1
OUT_M2: C313.1, C316.1, L301.2, R318.2, R322.1
POE_12V: Q302.6 (D), Q305.5 (D)
SW_3V3: C309.1, L302.1, U302.2 (SW)
SW_5V: C310.1, L303.1, U303.8 (SW)
SW_M2: C308.1, L301.1, U301.2 (SW)
VCC: C302.2, C303.1, C304.1, C305.1, C306.1, C307.1, D303.1 (C), Q307.5 (D), R308.2, R310.2, R311.2, R313.2, TP301.1, U301.3 (VIN), U302.3 (VIN), U303.2 (VIN)
VCC_5V: C311.2, R315.1, U303.9 (VCC)
VCC_IN: C301.2, Q301.4 (S), Q302.4 (S), Q303.4 (S), Q304.1 (S), Q304.2 (S), Q304.3 (S), Q305.1 (S), Q305.2 (S), Q305.3 (S), Q306.1 (S), Q306.2 (S), Q306.3 (S), Q307.1 (S), Q307.2 (S), Q307.3 (S), R307.2, R308.1, R328.2, TP310.1
V_{BUS}: Q303.6 (D), Q306.5 (D), TP308.1

Notes on the sheet:
(NFC, CSI, SD, Proximity, ..)
Power requirements & supplies:
3V3 DCDC (Main)
3V3 DCDC (M.2 NVMe)
3V3 @ 3A
5V @ 6A
Primary power - DC Jack input (9-15V)
Input selector & soft start
3V3 @3A: GPIO conn: 3A (max) CSI: 1.5A (max) LED Strip: 1A (may be switched to 5V) DSI adapter: 0.5A (max) NFC: 350mA+ SD card: 100m+? proximity: 50mA/ 1A (max) GPIO expander/levelshifters: 50mA 3V3-NVMe @3A: M.2: 3A 3V3 @600mA (from CM4) unused 1V8 @600mA (from CM4) unused
VCC(9-15V, nom. 12V): DCDC 5V: 2.8A DCDC 3V3: 1.1A x2 5V @6A: CM: 2A(RPi)/3A(PF) GPIO conn.: 3A(max) USB source: 1.5A CSI: 1.5A(max) LED Strip (DNP): 1A DSI adapter: 0.8A(LVDS); 2A(max) HDMI: 50mA+
5V DCDC
