antmicro/cm4-baseboard/usb.kicad_sch

## KiCad design usb.kicad_sch (2024-09-13)

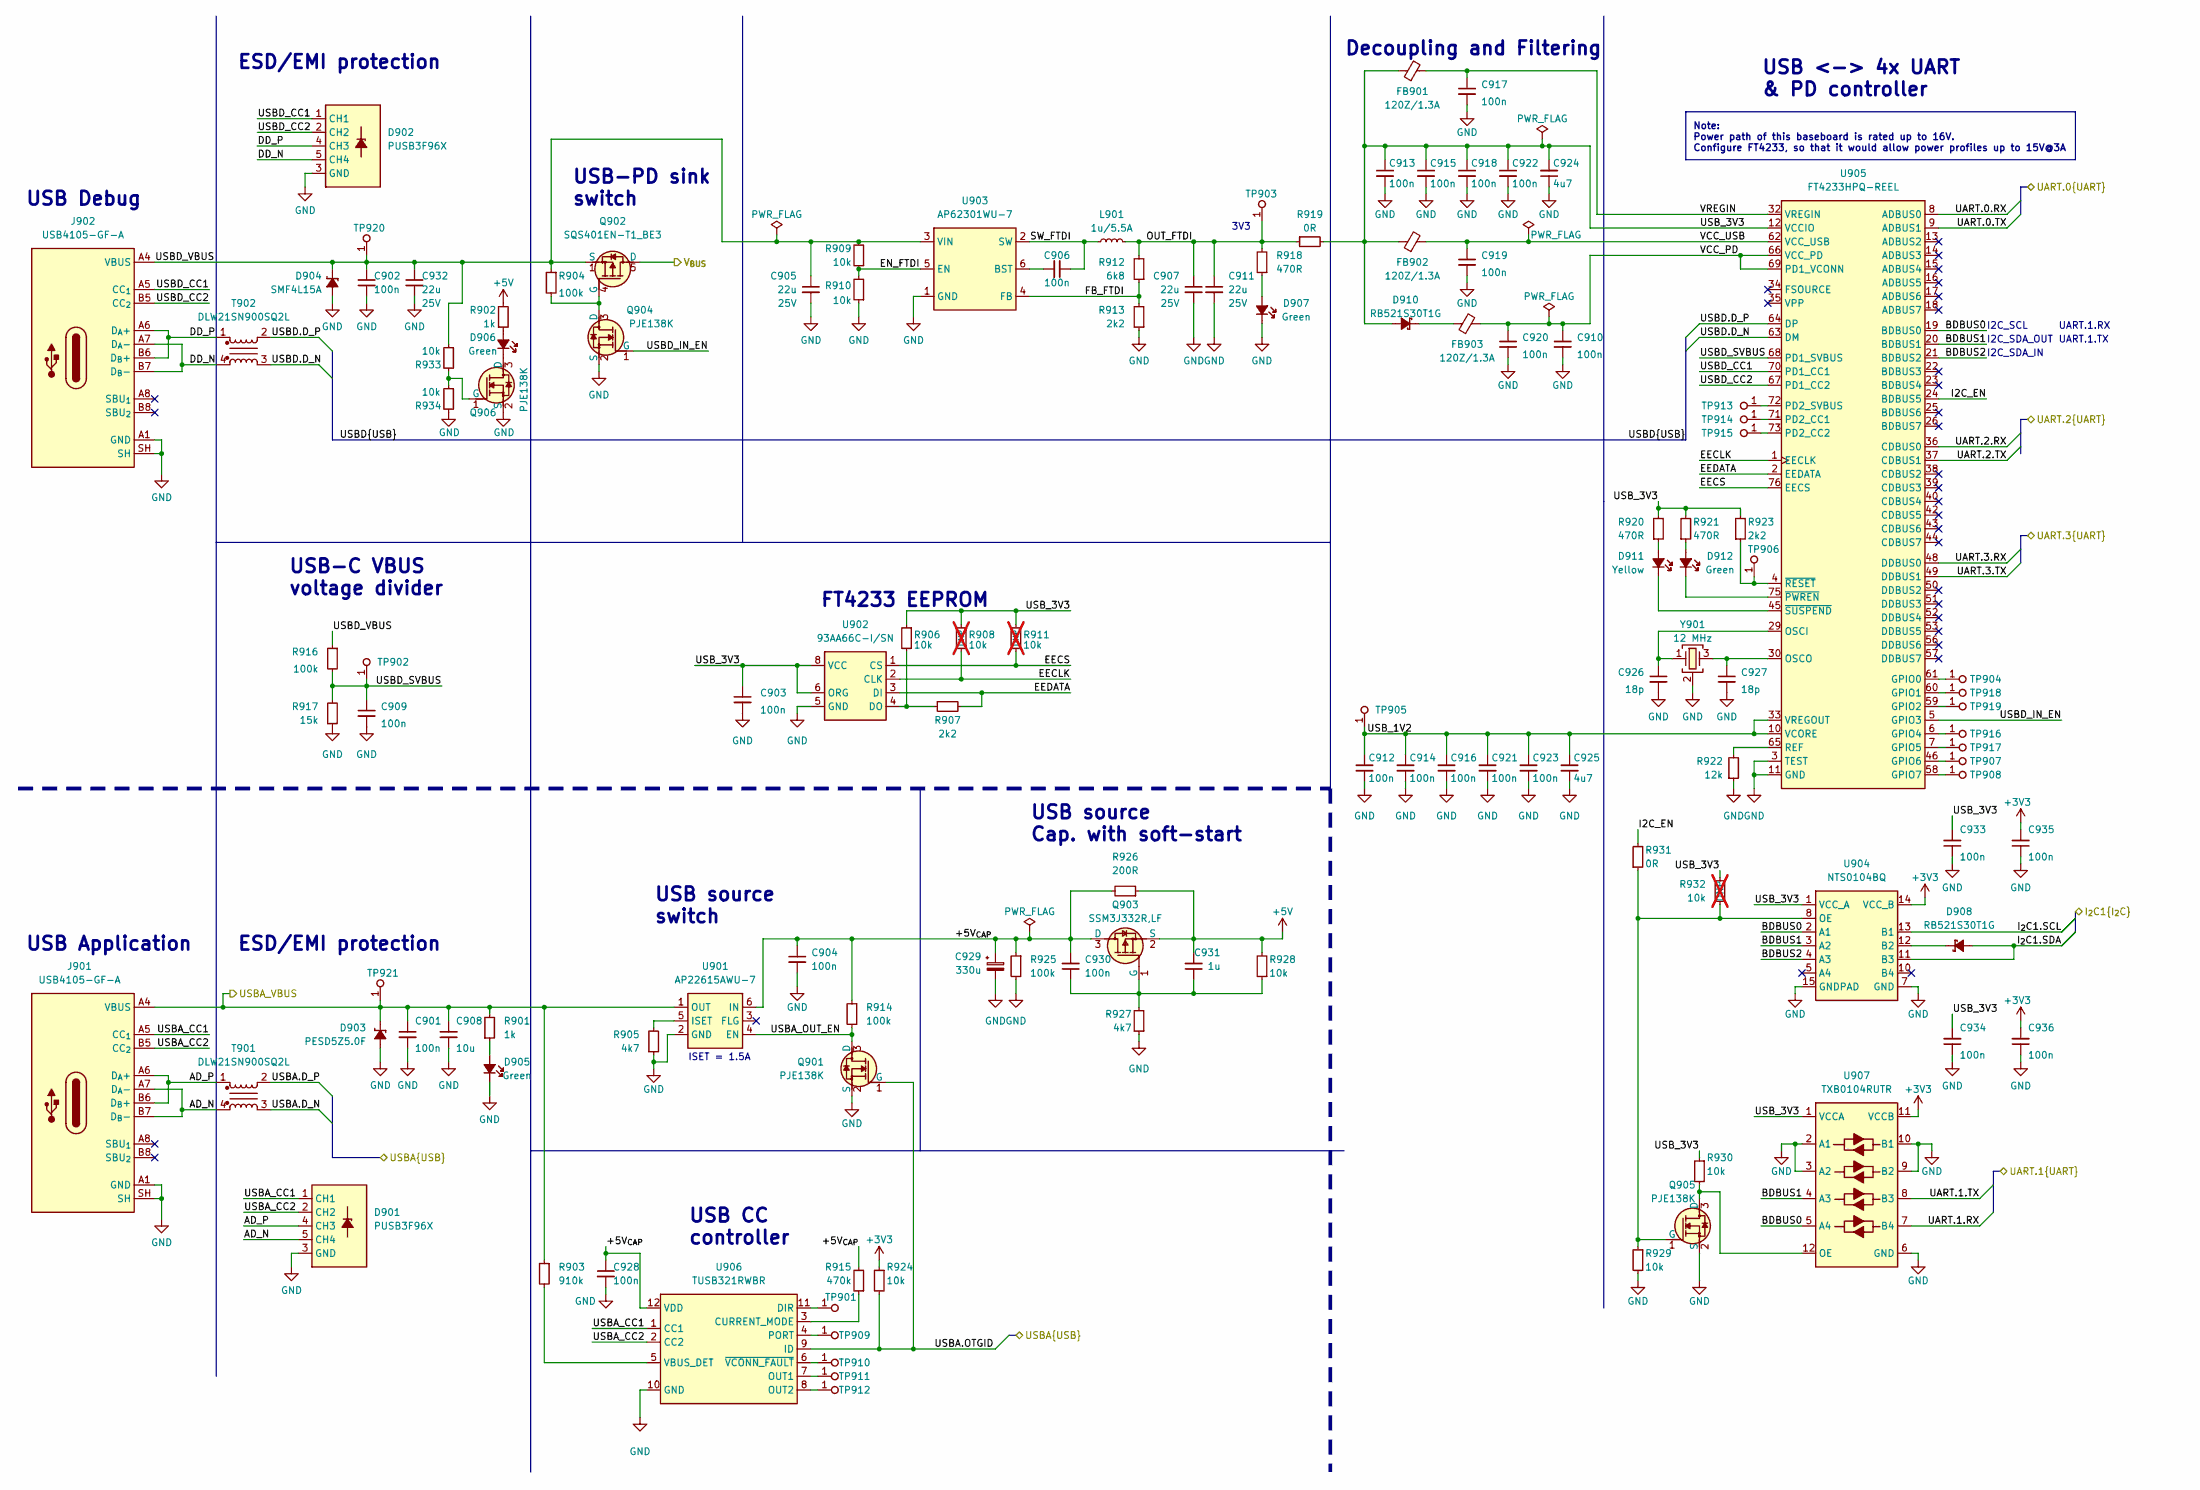
[picture p29: schematic usb.kicad_sch]

Parts:
C901, C902, C903, C904, C906, C909, C910, C912, C913, C914, C915, C916, C917, C918, C919, C920, C921, C922, C923, C928, C930, C933, C934, C935, C936: C_100n_0402; C_0402_1005Metric; Voltage 50V; MPN GRM155R61H104KE14D
C905, C907, C911, C932: C_22u_25V_0805; C_0805_2012Metric; Voltage 25V; MPN CL21A226MAYNNNE
C908: C_10u_0402; C_0402_1005Metric; MPN CC0402MRX5R5BB106
C924, C925: C_4u7_0402; C_0402_1005Metric; MPN GRM155R61A475MEAAD
C926, C927: C_18p_0402; C_0402_1005Metric; MPN CL05C180JB51PNC
C929: C_Pol_330u_6.3V_KEMET-T520-B; C_Pol_EIA-B; Voltage 6.3V; MPN T520B337M006ATE040
C931: C_1u_25V_0402; C_0402_1005Metric; Voltage 25V; MPN GRM155R61E105KE11J
D901, D902: PUSB3F96X_PASS; Nexperia_DFN-10_2.5x1mm_P0.5mm; MPN PUSB3F96X
D903: PESD5Z5_0F; SOD-523; MPN PESD5Z5.0F
D904: SMF4L15A; SOD-123FL; MPN SMF4L15A
D905, D906, D907, D912: LED_G_0603_KP-1608CGCK; LED_0603_1608Metric_G; MPN KP-1608CGCK
D908, D910: RB521S30T1G; SOD-523; MPN RB521S30T1G
D911: LED_Y_0402_VLMY1500-GS08; LED_0402_1005Metric_Y; MPN VLMY1500-GS08
FB901, FB902, FB903: FB_120Z_1.3A_Murata-BLM15PD_0402; FB_0402_1005Metric; MPN BLM15PD121SN1D
J901, J902: USB-C_GCT_USB4105-GF-A; USB-C_Receptacle_GCT_USB4105-GF-A; MPN USB4105-GF-A
L901: L_1u_5.5A_Bourns-SRP3212A; L_Bourns-SRP3212A; MPN SRP3212A-1R0M
Q901, Q904, Q905, Q906: PJE138K; SOT-523; MPN PJE138K_R1_00001
Q902: SQS401EN-T1_BE3; Vishay_PowerPAK_1212-8_Single; MPN SQS401EN-T1_BE3
Q903: SSM3J332R; SOT-23-3; MPN SSM3J332R,LF
R901, R902: R_1k_0402; R_0402_1005Metric; Tolerance 1%; MPN CR0402-FX-1001GLF
R903: R_910k_0402; R_0402_1005Metric; Tolerance 1%; MPN CR0402-FX-9103GLF
R904, R914, R916, R925: R_100k_0402; R_0402_1005Metric; Tolerance 1%; MPN CR0402-FX-1003GLF
R905, R927: R_4k7_0402; R_0402_1005Metric; Tolerance 1%; MPN CR0402-FX-4701GLF
R906, R909, R910, R924, R928, R929, R930, R933, R934: R_10k_0402; R_0402_1005Metric; Tolerance 1%; MPN CR0402-FX-1002GLF
R907, R913, R923: R_2k2_0402; R_0402_1005Metric; Tolerance 1%; MPN CR0402-FX-2201GLF
R908, R911, R932: R_10k_0402; R_0402_1005Metric; Tolerance 1%; MPN CR0402-FX-1002GLF; not fitted
R912: R_6k8_0402; R_0402_1005Metric; Tolerance 1%; MPN CR0402-FX-6801GLF
R915: R_470k_0402; R_0402_1005Metric; Tolerance 1%; MPN CR0402-FX-4703GLF
R917: R_15k_0402; R_0402_1005Metric; Tolerance 1%; MPN CR0402-FX-1502GLF
R918, R920, R921: R_470R_0402; R_0402_1005Metric; Tolerance 1%; MPN CR0402-FX-4700GLF
R919, R931: R_0R_0402; R_0402_1005Metric; MPN ERJ2GE0R00X
R922: R_12k_0402; R_0402_1005Metric; Tolerance 1%; MPN CR0402-FX-1202GLF
R926: R_200R_0402; R_0402_1005Metric; Tolerance 1%; MPN CR0402-FX-2000GLF
T901, T902: Choke_DLW21SN900SQ2L; Choke_Murata-DLW21; MPN DLW21SN900SQ2L
TP901, TP902, TP903, TP904, TP905, TP906, TP907, TP908, TP909, TP910, TP911, TP912, TP913, TP914, TP915, TP916, TP917, TP918, TP919, TP920, TP921: TP_0.75mm_SMD; TP_SMD_0.75mm
U901: AP22615A_TSOT26; TSOT23-6; MPN AP22615AWU-7
U902: 93AA66C_SOIC; SOIC-8_3.9x4.9x1.75mm_P1.27mm; MPN 93AA66C-I/SN
U903: AP62301_TSOT; TSOT23-6; MPN AP62301WU-7
U904: NTS0104_DHVQFN; DHVQFN-14-1EP_2.5x3mm; MPN NTS0104BQ
U905: FT4233HPQ; QFN-76-1EP_9x9mm_P0.4mm_EP6.3x6.3mm; MPN FT4233HPQ-REEL
U906: TUSB321RWBR; Texas_X2QFN-12_1.6x1.6mm_P0.4mm; MPN TUSB321RWBR
U907: TXB0104_UQFN; UQFN-12_2x1.7mm_P0.4mm_Texas_RUT; MPN TXB0104RUTR
Y901: Resonator_12MHz_ABM8G; Resonator_SMD_Abracon_ABM8G_3.2x2.5mm; MPN ABM8G-12.000MHZ-18-D2Y-T

Connections:
+3V3: C935.2, C936.2, R924.1, U904.14 (VCC_B), U907.11 (VCCB)
+5V: C931.2, Q903.2 (S), R902.2, R926.1, R928.2
+5V_{CAP}: C904.1, C928.1, C929.1, C930.2, Q903.3 (D), R914.1, R915.2, R925.1, R926.2, U901.6 (IN), U906.12 (VDD)
AD_N: D901.5 (CH4), D901.6 (CH4), J901.A7 (D_{A}-), J901.B7 (D_{B}-), T901.4
AD_P: D901.4 (CH3), D901.7 (CH3), J901.A6 (D_{A}+), J901.B6 (D_{B}+), T901.1
BDBUS0: U904.2 (A1), U905.19 (BDBUS0), U907.5 (A4)
BDBUS1: U904.3 (A2), U905.20 (BDBUS1), U907.4 (A3)
BDBUS2: U904.4 (A3), U905.21 (BDBUS2)
DD_N: D902.5 (CH4), D902.6 (CH4), J902.A7 (D_{A}-), J902.B7 (D_{B}-), T902.4
DD_P: D902.4 (CH3), D902.7 (CH3), J902.A6 (D_{A}+), J902.B6 (D_{B}+), T902.1
EECLK: R908.2, U902.2 (CLK), U905.1 (EECLK)
EECS: R911.2, U902.1 (CS), U905.76 (EECS)
EEDATA: R907.2, U902.3 (DI), U905.2 (EEDATA)
EN_FTDI: R909.1, R910.2, U903.5 (EN)
FB_FTDI: R912.1, R913.2, U903.4 (FB)
GND: C901.2, C902.1, C903.2, C904.2, C905.2, C907.2, C908.1, C909.2, C910.2, C911.2, C912.2, C913.2, C914.2, C915.2, C916.2, C917.2, C918.2, C919.2, C920.2, C921.2, C922.2, C923.2, C924.1, C925.2, C926.2, C927.2, C928.2, C929.2, C932.2, C933.1, C934.1, C935.1, C936.1, D901.3 (GND), D901.8 (GND), D902.3 (GND), D902.8 (GND), D903.2 (A), D904.2 (A), D905.1 (C), D907.1 (C), J901.A1 (GND), J901.A12 (GND), J901.B1 (GND), J901.B12 (GND), J901.SH, J902.A1 (GND), J902.A12 (GND), J902.B1 (GND), J902.B12 (GND), J902.SH, Q901.2 (S), Q904.2 (S), Q905.2 (S), Q906.2 (S), R905.1, R910.1, R913.1, R917.1, R922.1, R925.2, R927.1, R929.2, R934.2, U901.2 (GND), U902.5 (GND), U903.1 (GND), U904.7 (GND), U904.15 (GNDPAD), U905.3 (TEST), U905.11 (GND), U905.31 (GND), U905.55 (GND), U905.77 (GND), U906.10 (GND), U907.2 (A1), U907.3 (A2), U907.6 (GND), U907.9 (B2), U907.10 (B1), Y901.2 (SH), Y901.4 (SH)
I2C_EN: R931.2, U905.24 (BDBUS5)
I_{2}C1.SCL: U904.13 (B1)
I_{2}C1.SDA: D908.2 (A), U904.11 (B3)
unnamed: C906.2, U903.6 (BST)
unnamed: C926.1, U905.29 (OSCI), Y901.1
unnamed: C927.1, U905.30 (OSCO), Y901.3
unnamed: C930.1, C931.1, Q903.1 (G), R927.2, R928.1
unnamed: D905.2 (A), R901.1
unnamed: D906.1 (C), Q906.3 (D)
unnamed: D906.2 (A), R902.1
unnamed: D907.2 (A), R918.1
unnamed: D908.1 (C), U904.12 (B2)
unnamed: D910.1 (C), FB903.1
unnamed: D911.1 (C), U905.45 (~SUSPEND)
unnamed: D911.2 (A), R920.1
unnamed: D912.1 (C), U905.75 (~PWREN)
unnamed: D912.2 (A), R921.1
unnamed: Q902.4 (G), Q904.3 (D), R904.2
unnamed: Q905.1 (G), R929.1, R931.1, R932.1, U904.8 (OE)
unnamed: Q905.3 (D), R930.2, U907.12 (OE)
unnamed: Q906.1 (G), R933.2, R934.1
unnamed: R903.2, U906.5 (VBUS_DET)
unnamed: R905.2, U901.5 (ISET)
unnamed: R906.2, R907.1, U902.4 (DO)
unnamed: R915.1, U906.3 (CURRENT_MODE)
unnamed: R922.2, U905.65 (REF)
unnamed: R923.1, TP906.1, U905.4 (~RESET)
unnamed: TP901.1, U906.11 (DIR)
unnamed: TP904.1, U905.61 (GPIO0)
unnamed: TP907.1, U905.46 (GPIO6)
unnamed: TP908.1, U905.58 (GPIO7)
unnamed: TP909.1, U906.4 (PORT)
unnamed: TP910.1, U906.6 (~VCONN_FAULT)
unnamed: TP911.1, U906.7 (OUT1)
unnamed: TP912.1, U906.8 (OUT2)
unnamed: TP913.1, U905.72 (PD2_SVBUS)
unnamed: TP914.1, U905.71 (PD2_CC1)
unnamed: TP915.1, U905.73 (PD2_CC2)
unnamed: TP916.1, U905.6 (GPIO4)
unnamed: TP917.1, U905.7 (GPIO5)
unnamed: TP918.1, U905.60 (GPIO1)
unnamed: TP919.1, U905.59 (GPIO2)
OUT_FTDI: C907.1, C911.1, L901.2, R912.2, R918.2, R919.1, TP903.1
SW_FTDI: C906.1, L901.1, U903.2 (SW)
UART.0.RX: U905.8 (ADBUS0)
UART.0.TX: U905.9 (ADBUS1)
UART.1.RX: U907.7 (B4)
UART.1.TX: U907.8 (B3)
UART.2.RX: U905.36 (CDBUS0)
UART.2.TX: U905.37 (CDBUS1)
UART.3.RX: U905.48 (DDBUS0)
UART.3.TX: U905.49 (DDBUS1)
USBA.D_N: T901.3
USBA.D_P: T901.2
USBA.OTGID: Q901.1 (G), R924.2, U906.9 (ID)
USBA_CC1: D901.1 (CH1), D901.10 (CH1), J901.A5 (CC_{1}), U906.1 (CC1)
USBA_CC2: D901.2 (CH2), D901.9 (CH2), J901.B5 (CC_{2}), U906.2 (CC2)
USBA_OUT_EN: Q901.3 (D), R914.2, U901.4 (EN)
USBA_VBUS: C901.1, C908.2, D903.1 (C), J901.A4 (VBUS), J901.A9 (VBUS), J901.B4 (VBUS), J901.B9 (VBUS), R901.2, R903.1, TP921.1, U901.1 (OUT)
USBD.D_N: T902.3, U905.63 (DM)
USBD.D_P: T902.2, U905.64 (DP)
USBD_CC1: D902.1 (CH1), D902.10 (CH1), J902.A5 (CC_{1}), U905.70 (PD1_CC1)
USBD_CC2: D902.2 (CH2), D902.9 (CH2), J902.B5 (CC_{2}), U905.67 (PD1_CC2)
USBD_IN_EN: Q904.1 (G), U905.5 (GPIO3)
USBD_SVBUS: C909.1, R916.2, R917.2, TP902.1, U905.68 (PD1_SVBUS)
USBD_VBUS: C902.2, C905.1, C932.1, D904.1 (C), J902.A4 (VBUS), J902.A9 (VBUS), J902.B4 (VBUS), J902.B9 (VBUS), Q902.1 (S), Q902.2 (S), Q902.3 (S), R904.1, R909.2, R916.1, R933.1, TP920.1, U903.3 (VIN)
USB_1V2: C912.1, C914.1, C916.1, C921.1, C923.1, C925.1, TP905.1, U905.10 (VCORE), U905.27 (VCORE), U905.33 (VREGOUT), U905.47 (VCORE), U905.74 (VCORE)
USB_3V3: C903.1, C913.1, C915.1, C918.1, C922.1, C924.2, C933.2, C934.2, D910.2 (A), FB901.1, FB902.1, R906.1, R908.1, R911.1, R919.2, R920.2, R921.2, R923.2, R930.1, R932.2, U902.6 (ORG), U902.8 (VCC), U904.1 (VCC_A), U905.12 (VCCIO), U905.28 (VCCIO), U905.41 (VCCIO), U905.54 (VCCIO), U907.1 (VCCA)
VCC_PD: C910.1, C920.1, FB903.2, U905.66 (VCC_PD), U905.69 (PD1_VCONN)
VCC_USB: C919.1, FB902.2, U905.62 (VCC_USB)
VREGIN: C917.1, FB901.2, U905.32 (VREGIN)
V_{BUS}: Q902.5 (D)

Notes on the sheet:
I2C_SDA_OUT
ISET = 1.5A
Note: Power path of this baseboard is rated up to 16V. Configure FT4233, so that it would allow power profiles up to 15V@3A
USB Debug
ESD/EMI protection
FT4233 EEPROM
USB-C VBUS voltage divider
3V3
Decoupling and Filtering
USB source switch
I2C_SCL
I2C_SDA_IN
USB CC controller
UART.1.RX
USB-PD sink switch
USB Application
UART.1.TX
USB source Cap. with soft-start
USB <-> 4x UART & PD controller
