antmicro/cm4-baseboard/(commit log)

2024-01-19 Initial schematic and component placement
    [cm4-baseboard.kicad_sch, compute-module.kicad_sch, csi.kicad_sch, debug.kicad_sch, display.kicad_sch, dsi-lvds.kicad_sch, ethernet.kicad_sch, nvme-micro-sd.kicad_sch]
2024-01-23 [#53805] Clean ETH schematic; restore bus definitions
    [cm4-baseboard.kicad_sch, ethernet.kicad_sch, supply.kicad_sch]
2024-01-23 [#53805] Align designators in ETH; set project revision to 1.0.0
    [cm4-baseboard.kicad_sch, compute-module.kicad_sch, csi.kicad_sch, debug.kicad_sch, display.kicad_sch, dsi-lvds.kicad_sch, ethernet.kicad_sch, nvme-micro-sd.kicad_sch]
2024-01-23 [#53805] Change designators orientation in ETH sch
    [cm4-baseboard.kicad_sch, ethernet.kicad_sch]
2024-01-23 [#53901] Update capacitor symbols from lib
    [cm4-baseboard.kicad_sch, ethernet.kicad_sch]
2024-01-24 [#53804] Clean SD&NVMe sch; Change NVMe to x4; Update 3V3 power sch
    [cm4-baseboard.kicad_sch, compute-module.kicad_sch, nvme-micro-sd.kicad_sch, supply.kicad_sch]
2024-01-24 [#53804] Visual cleanup for m.2/SD sch
    [cm4-baseboard.kicad_sch, compute-module.kicad_sch, nvme-micro-sd.kicad_sch]
2024-01-25 [#54172] Peripherals: add passives to PN7160A, update PN7160A symbol
    [cm4-baseboard.kicad_sch, compute-module.kicad_sch, peripherials.kicad_sch]
2024-01-26 [#54231] Add DSI/LVDS converter
    [dsi-lvds.kicad_sch]
2024-01-26 [#54231] Add LVDS connector
    [lvds.kicad_sch]
2024-01-26 [#54231] Add DSI connector; update hierarchic sch connections
    [cm4-baseboard.kicad_sch, compute-module.kicad_sch, display.kicad_sch]
2024-01-26 [#54231] Clean HDMI connections
    [cm4-baseboard.kicad_sch, compute-module.kicad_sch, display.kicad_sch, dsi-lvds.kicad_sch, lvds.kicad_sch]
2024-01-30 [#54231] Complete Touchscreen connections
    [display.kicad_sch]
2024-01-30 [#54231] Clean display sch
    [display.kicad_sch]
2024-01-30 [#54231] Add initial power supply for LVDS display
    [cm4-baseboard.kicad_sch, display.kicad_sch, lvds.kicad_sch]
2024-01-30 [#54231] Clean backlight driver sch
    [lvds.kicad_sch]
2024-01-30 [#54231] Rename bus DSI/LVDS to DisplayCtrl
    [cm4-baseboard.kicad_sch, compute-module.kicad_sch, display.kicad_sch, dsi-lvds.kicad_sch]
2024-01-30 [#54231] Update power sequencing for LVDS display
    [cm4-baseboard.kicad_sch, display.kicad_sch, lvds.kicad_sch]
2024-01-30 [#54231] Clean power supply for LVDS display
    [cm4-baseboard.kicad_sch, lvds.kicad_sch, supply.kicad_sch]
2024-01-30 [#54437] Clean CSI connections schematic
    [cm4-baseboard.kicad_sch, compute-module.kicad_sch, csi.kicad_sch]
2024-01-30 [#54447] Add Sensor & LED connectors
    [cm4-baseboard.kicad_sch, compute-module.kicad_sch, peripherials.kicad_sch]
2024-01-30 [#54447] Start CM4 connections
    [cm4-baseboard.kicad_sch, compute-module.kicad_sch, display.kicad_sch]
2024-01-30 [#54447] CM4 connections part 2
    [cm4-baseboard.kicad_sch, compute-module.kicad_sch, display.kicad_sch, supply.kicad_sch]
2024-01-30 [#54447] CM4 connections part 3
    [cm4-baseboard.kicad_sch, compute-module.kicad_sch, display.kicad_sch]
2024-01-31 [#54447] Complete CM4 connections- GPIO expander
    [cm4-baseboard.kicad_sch, compute-module.kicad_sch, display.kicad_sch]
2024-01-31 [#54447] Add GPIO connector
    [cm4-baseboard.kicad_sch, compute-module.kicad_sch, display.kicad_sch, peripherials.kicad_sch]
2024-02-02 [#54447] Fix pin order of Sensor&LED connectors; add ESD protection to these conns
    [peripherials.kicad_sch]
2024-02-05 [#54447] Add testpoints to unused pins of PN7160
    [peripherials.kicad_sch]
2024-02-05 [#54474] Complete USB schematics
    - merge sch usb&debug
    - add USB/4xUART bridge
    - add USB-PD managament
    [cm4-baseboard.kicad_sch, compute-module.kicad_sch, debug.kicad_sch, display.kicad_sch, ethernet.kicad_sch, lvds.kicad_sch, peripherials.kicad_sch, supply.kicad_sch]
2024-02-05 [#54474] Change sheet placement in top sheet
    [cm4-baseboard.kicad_sch, supply.kicad_sch]
2024-02-05 [#54474] Fix broken capacitor symbols
    [display.kicad_sch, lvds.kicad_sch]
2024-02-05 [#54474] Fix USB VBUS switching
    [usb.kicad_sch]
2024-02-05 [#54474] Tie EEPROM ORG pin to USB_3V3
    [usb.kicad_sch]
2024-02-05 [#54476] Update note about power requirements
    [cm4-baseboard.kicad_sch, supply.kicad_sch]
2024-02-05 [#54476] Complete power supply
    - add USB-PD input
    - change DCDC 5V
    - add power indicators
    [cm4-baseboard.kicad_sch, supply.kicad_sch]
2024-02-06 [#54617] Migrate PCB to KiCad 7
2024-02-06 [#53967] Remove LVDS display related from PCB; minor placement update
2024-02-06 [#53967] PCB: Review(hstefaniak) requested changes; add connectors for NFC & AntmUD
2024-02-08 [#53967] PCB: change display adapter connector footprint
2024-02-09 [#53967] PCB: change FT4233 footprint
2024-02-09 [#53967] PCB: minor adjustment of adapter placement
2024-02-09 [#55037] Add m.2 2230 ssd blend for assembly
    [Mech_M2_2230_H2.5mm_SSD.blend]
2024-02-09 [#55037] Update m.2 2230 ssd blend for assembly
    [Mech_M2_2230_H2.5mm_SSD.blend]
2024-02-09 [#53967] PCB: change m.2 & sd card placement
2024-02-12 [#54617] Add option to switch IO level to 1V8
    [cm4-baseboard.kicad_sch, compute-module.kicad_sch]
2024-02-12 [#54617] Clean labels: align & reduce duplicates
    [cm4-baseboard.kicad_sch, compute-module.kicad_sch, csi.kicad_sch, lvds.kicad_sch, usb.kicad_sch]
2024-02-12 [#54617] Update SN65DSI84 symbol
    [cm4-baseboard.kicad_sch, display.kicad_sch, dsi-lvds.kicad_sch]
2024-02-12 [#54617] Add pull-up on DisplayCtrl.EN
    [cm4-baseboard.kicad_sch, lvds.kicad_sch]
2024-02-12 [#54617] Apply changes pointed in review, related to nvme-micro-sd
    [cm4-baseboard.kicad_sch, compute-module.kicad_sch, nvme-micro-sd.kicad_sch]
2024-02-12 [#54617] Add wakeup button to CM; Add some testpoints to CM
    [cm4-baseboard.kicad_sch, compute-module.kicad_sch, display.kicad_sch]
2024-02-12 [#54617] Change how CSI switches decoupling capacitors are placed on schematic
    [cm4-baseboard.kicad_sch, compute-module.kicad_sch, csi.kicad_sch]
2024-02-12 [#54617] Add ESD/EMI protection on HDMI
    [cm4-baseboard.kicad_sch, display.kicad_sch]
2024-02-12 [#54617] Change all NMOS to be single MPN
    [cm4-baseboard.kicad_sch, compute-module.kicad_sch, lvds.kicad_sch]
2024-02-12 [#54617] Uniform diodes MPN
    [cm4-baseboard.kicad_sch, csi.kicad_sch, ethernet.kicad_sch, supply.kicad_sch]
2024-02-12 [#54617] Reduce capacitors diversity
    [cm4-baseboard.kicad_sch, display.kicad_sch, ethernet.kicad_sch, nvme-micro-sd.kicad_sch, peripherials.kicad_sch, supply.kicad_sch, usb.kicad_sch]
2024-02-12 [#54617] Reduce resistors diversity (switch size to 0402)
    [cm4-baseboard.kicad_sch, compute-module.kicad_sch, ethernet.kicad_sch, lvds.kicad_sch, nvme-micro-sd.kicad_sch, usb.kicad_sch]
2024-02-12 [#54617] Connect VSYNC0/1 & WKUP_REQ through 0R-DNP to CM
    [cm4-baseboard.kicad_sch, compute-module.kicad_sch, display.kicad_sch, peripherials.kicad_sch]
2024-02-12 [#54617] NFC: mark matching network as DNP & add note about it
    [cm4-baseboard.kicad_sch, lvds.kicad_sch, peripherials.kicad_sch]
2024-02-12 [#54617] Migrate to KiCad 7
    [cm4-baseboard.kicad_sch, compute-module.kicad_sch, csi.kicad_sch, display.kicad_sch, dsi-lvds.kicad_sch, ethernet.kicad_sch, lvds.kicad_sch, nvme-micro-sd.kicad_sch]
2024-02-12 [#54617] Move LVDS display related components to separate repo
    [cm4-baseboard.kicad_sch, compute-module.kicad_sch, display.kicad_sch, dsi-lvds.kicad_sch, lvds.kicad_sch, peripherials.kicad_sch]
2024-02-12 [#54617] Review requested: change DCDC feedback resistors; add divider at EN
    [supply.kicad_sch]
2024-02-12 [#54617] Review requested: minor visual update
    [cm4-baseboard.kicad_sch, peripherials.kicad_sch]
2024-02-12 [#54617] Fix UART: flip rx/tx
    [usb.kicad_sch]
2024-02-12 [#54617] Review requested: Change ideal diode controller
    [supply.kicad_sch]
2024-02-12 [#54617] Update FT4233 symbol from lib
    [usb.kicad_sch]
2024-02-12 [#54617] Update bus naming; remove DNP for TVS
    [cm4-baseboard.kicad_sch, display.kicad_sch, peripherials.kicad_sch, usb.kicad_sch]
2024-02-12 [#54617] Review requested changes
    [cm4-baseboard.kicad_sch, compute-module.kicad_sch, csi.kicad_sch, display.kicad_sch, ethernet.kicad_sch, nvme-micro-sd.kicad_sch, peripherials.kicad_sch, supply.kicad_sch]
2024-02-12 [#54617] Re-enumerate reference designators
    [cm4-baseboard.kicad_sch, compute-module.kicad_sch, csi.kicad_sch, display.kicad_sch, ethernet.kicad_sch, nvme-micro-sd.kicad_sch, peripherials.kicad_sch, supply.kicad_sch]
2024-02-12 [#54932] Change adapter connector (from 2x15 to 2x20)
    [display.kicad_sch]
2024-02-12 [#54617] Change level shifter for I2C
    [compute-module.kicad_sch, display.kicad_sch]
2024-02-12 [#54617] Remove CM chokes for HDMI & DSI; change CM chokes for USB
    [display.kicad_sch, usb.kicad_sch]
2024-02-21 [#55181] Rotate board; Change CSI&SD position; Update adapter; NFC placement
    [compute-module.kicad_sch, peripherials.kicad_sch, supply.kicad_sch]
2024-02-21 [#55181] PCB: PoE: Placement
    [display.kicad_sch, supply.kicad_sch]
2024-02-21 [#55181] PCB: Assign netclasses for diff pairs; Schetchy routing of Ethernet
2024-02-21 [#55181] PCB: power supply placement; power routing draft
2024-02-21 [#55181] PCB: NVMe disc: placement and HS routing; minor related changes in sch
    [compute-module.kicad_sch]
2024-02-21 [#55247] Change USB schematic: Remove PD from App USB, add CC controller
    [cm4-baseboard.kicad_sch, compute-module.kicad_sch, csi.kicad_sch, display.kicad_sch, usb.kicad_sch]
2024-02-21 [#55181] PCB: CSI placement
2024-02-21 [#55181] PCB: HDMI & adapter conn. placement
    [display.kicad_sch]
2024-02-21 [#55181] Placement: SD& GPIO; Change adapter conn. back to H2mm; flip adapter stub
    [display.kicad_sch, nvme-micro-sd.kicad_sch]
2024-02-21 [#55181] PCB: CSI HS initial routing
    [nvme-micro-sd.kicad_sch]
2024-02-21 [#55181] PCB: DSI & HDMI HS initial routing
2024-02-21 [#55181] PCB: USB placement; Sch: minor USB related changes
    [cm4-baseboard.kicad_sch, compute-module.kicad_sch, usb.kicad_sch]
2024-02-21 [#55181] PCB: CM related componets placement; correct net classes names
2024-02-21 [#55181] Change adapter spacer to 2mm; update spacers from lib
    [cm4-baseboard.kicad_sch, compute-module.kicad_sch, display.kicad_sch, nvme-micro-sd.kicad_sch]
2024-02-21 [#55181] PCB: Tune ETH routing
    [ethernet.kicad_sch]
2024-02-21 [#55181] PCB: fix CSI0 routing; add SDIO routing; rearange power distribution
2024-02-21 [#55532] PCB power section routing
2024-02-21 [#55532] PCB: update power distribution
2024-02-23 [#55181] Minor PCB placement improvements
2024-02-26 [#55532] PCB: update HS routing (change width; add gnd vias)
    [compute-module.kicad_sch]
2024-02-26 Sch: Clean incorrect symbol references; Cleanup DNPs
    [compute-module.kicad_sch, ethernet.kicad_sch, nvme-micro-sd.kicad_sch, peripherials.kicad_sch, supply.kicad_sch]
2024-02-26 [#55181] PCB: update DCDC(5V & 3V3) layout; Sch: correct 5V DCDC feedback
    [supply.kicad_sch]
2024-02-27 [#55181] PCB: update DCDC(M.2) layout
2024-02-27 Update I2C connections (use GPIO44/45 for board I2C; drop level shifter)
    [compute-module.kicad_sch, peripherials.kicad_sch]
2024-02-27 [#55181] PCB: Review requests(reduce comp. on bottom, increase comp. spacing)
2024-02-27 [#55181] PCB: Connect GPIOs of CM
    [peripherials.kicad_sch]
2024-02-28 [#55532] PCB: move SDIO routing to bottom
2024-02-29 [#55532] PCB: Connect GPIOs of CM
    [compute-module.kicad_sch]
2024-02-29 [#55532] Sch: Optimize conections for easier routing
    [cm4-baseboard.kicad_sch, compute-module.kicad_sch, csi.kicad_sch, display.kicad_sch, peripherials.kicad_sch, usb.kicad_sch]
2024-02-29 [#55532] PCB: Long range routing, mostly routing gpio expander
2024-03-01 [#55532] PCB: Finish long range routing
2024-03-01 [#55532] PCB: Add GND pour on all layers with keepout around HS routes
2024-03-01 [#55532] PCB: NFC routing
    [peripherials.kicad_sch]
2024-03-01 [#55532] PCB: GPIO expander & level shifters routing
2024-03-01 [#55532] PCB: USB related routing- WIP
2024-03-04 [#55532] PCB: USB related routing
2024-03-04 [#55532] PCB: HDMI & DSI adapter conns related routing
    [display.kicad_sch]
2024-03-04 [#55532] PCB: move m.2 DCDC to bottom
2024-03-04 [#55532] PCB: QWIIC, CSI, GPIO conns, SD card & buttons related routing
2024-03-05 [#55532] Update USB sch according to review notes; update related layout
    [compute-module.kicad_sch, supply.kicad_sch, usb.kicad_sch]
2024-03-05 [#55532] PCB: routing around CM; general layout improvements
    [nvme-micro-sd.kicad_sch]
2024-03-05 [#55532] PCB: tune HS routing length
2024-03-05 [#55532] PCB: clean silkcreen on bottom
2024-03-05 [#55532] PCB: clean silkscreen on top
2024-03-06 [#55532] PCB: tune ETH routing
2024-03-06 [#55532] PCB: remove some DRC warnings
2024-03-06 [#55532] PCB: correct HS traces-GDN zones spaceing
2024-03-06 [#55532] PCB: fix missing GND zone connection
2024-03-08 [#55532] USB: add C to dcdc; add note-max Voltage; change TVS
    [supply.kicad_sch, usb.kicad_sch]
2024-03-08 [#56330] Clean ERC errors/warnings; update power supply notes
    [cm4-baseboard.kicad_sch, compute-module.kicad_sch, ethernet.kicad_sch, nvme-micro-sd.kicad_sch, peripherials.kicad_sch, supply.kicad_sch, usb.kicad_sch]
2024-03-08 [#56330] Add date to sch/pcb frames; add title & stackup table to pcb
    [cm4-baseboard.kicad_sch, compute-module.kicad_sch, csi.kicad_sch, display.kicad_sch, ethernet.kicad_sch, nvme-micro-sd.kicad_sch, peripherials.kicad_sch, supply.kicad_sch]
2024-03-11 [#56330] Correct power routing
2024-03-11 [#56330] PCB: Apply changes requested in review
2024-03-12 [#56330] PCB: Correct DSI.D1 & CSI.D1 dimensions; clean DRC/ERC
2024-03-12 [#56330] PCB: Remove vias from pads
2024-03-12 [#56330] PCB: Move boot switch close to buttons
2024-03-12 [#56330] Update date
    [cm4-baseboard.kicad_sch, compute-module.kicad_sch, csi.kicad_sch, display.kicad_sch, ethernet.kicad_sch, nvme-micro-sd.kicad_sch, peripherials.kicad_sch, supply.kicad_sch]
2024-03-12 [#56330] Update PCB SHA placeholder
2024-03-13 Fix incorrect value for some resistors
    [compute-module.kicad_sch, usb.kicad_sch]
2024-03-13 [#56447] Fix track-edge clearance
2024-03-13 [#56447] Update date
    [cm4-baseboard.kicad_sch, compute-module.kicad_sch, csi.kicad_sch, display.kicad_sch, ethernet.kicad_sch, nvme-micro-sd.kicad_sch, peripherials.kicad_sch, supply.kicad_sch]
2024-03-13 [#55037] Fix NVMe disc properities, so that it will be shown on visualisation
    [nvme-micro-sd.kicad_sch, usb.kicad_sch]
2024-03-14 [#55037] Remove shapes3d/
    [Mech_M2_2230_H2.5mm_SSD.blend]
2024-03-22 [#53901] Update symbols & footprints from lib
    [cm4-baseboard.kicad_sch, compute-module.kicad_sch, csi.kicad_sch, display.kicad_sch, ethernet.kicad_sch, nvme-micro-sd.kicad_sch, peripherials.kicad_sch, supply.kicad_sch]
2024-03-25 [#56708] Add OHP assets
    [stackup.csv]
2024-03-25 [#56708] Add loclib
    [cm4-baseboard.kicad_sch, compute-module.kicad_sch, csi.kicad_sch, display.kicad_sch, ethernet.kicad_sch, nvme-micro-sd.kicad_sch, peripherials.kicad_sch, supply.kicad_sch]
2024-04-02 [#56708] Update symbol/footprint props; Update modules visibilty
    [cm4-baseboard.kicad_sch, compute-module.kicad_sch, csi.kicad_sch, display.kicad_sch, ethernet.kicad_sch, nvme-micro-sd.kicad_sch, peripherals.kicad_sch, peripherials.kicad_sch]
2024-04-03 [#57496] README: Update features and board render
2024-04-15 [#57456] Remove loclib
    [cm4-baseboard.kicad_sch, compute-module.kicad_sch, csi.kicad_sch, display.kicad_sch, ethernet.kicad_sch, nvme-micro-sd.kicad_sch, peripherals.kicad_sch, supply.kicad_sch]
2024-04-17 [#58124] Fix GPIO expander I2C
    [compute-module.kicad_sch]
2024-04-17 [#58134] Remove I2C connection to FT4233
    [cm4-baseboard.kicad_sch, compute-module.kicad_sch, usb.kicad_sch]
2024-04-17 [#58122] LED related fixes & improvements
    [compute-module.kicad_sch, csi.kicad_sch, display.kicad_sch, ethernet.kicad_sch, nvme-micro-sd.kicad_sch, supply.kicad_sch, usb.kicad_sch]
2024-04-17 [#58133] Bump date&revision; Clean DRC
    [cm4-baseboard.kicad_sch, compute-module.kicad_sch, csi.kicad_sch, display.kicad_sch, ethernet.kicad_sch, nvme-micro-sd.kicad_sch, peripherals.kicad_sch, supply.kicad_sch]
2024-04-25 [#58133] Add high-power peripheral connector
    [compute-module.kicad_sch, display.kicad_sch, ethernet.kicad_sch, peripherals.kicad_sch, supply.kicad_sch]
2024-04-26 Revert "[#58133] Add high-power peripheral connector"
    This reverts commit a83347aca41b3b449620dbb955cb5f6a2460727a
    [compute-module.kicad_sch, display.kicad_sch, ethernet.kicad_sch, peripherals.kicad_sch, supply.kicad_sch]
2024-05-15 [#59206] Sch: Add I2C-master from FTDI
    [cm4-baseboard.kicad_sch, usb.kicad_sch]
2024-05-15 [#59206] PCB: Add I2C-master from FTDI
2024-05-15 [#58133] Update from lib
    [compute-module.kicad_sch, csi.kicad_sch, display.kicad_sch, ethernet.kicad_sch, nvme-micro-sd.kicad_sch, peripherals.kicad_sch, supply.kicad_sch, usb.kicad_sch]
2024-05-15 [#58133] Add more testpoints
    [compute-module.kicad_sch, csi.kicad_sch, ethernet.kicad_sch, supply.kicad_sch, usb.kicad_sch]
2024-05-15 [#58133] Clean DNPs
    [compute-module.kicad_sch, ethernet.kicad_sch, peripherals.kicad_sch, supply.kicad_sch, usb.kicad_sch]
2024-05-17 [#58133] Apply reviewers sugestions
    [compute-module.kicad_sch, usb.kicad_sch]
2024-05-17 [#58133] Bump date
    [cm4-baseboard.kicad_sch, compute-module.kicad_sch, csi.kicad_sch, display.kicad_sch, ethernet.kicad_sch, nvme-micro-sd.kicad_sch, peripherals.kicad_sch, supply.kicad_sch]
2024-05-17 [#58133] Fix overlapping designators in schematic
    [compute-module.kicad_sch, ethernet.kicad_sch, supply.kicad_sch, usb.kicad_sch]
2024-05-20 [#58133] Add jumper and pull-up resistor to PWR_LED net
    [compute-module.kicad_sch]
2024-06-19 [#61160] Mark matching network as DNP, clean DRC and ERC
    [cm4-baseboard.kicad_sch, compute-module.kicad_sch, csi.kicad_sch, display.kicad_sch, ethernet.kicad_sch, nvme-micro-sd.kicad_sch, peripherals.kicad_sch, supply.kicad_sch]
2024-06-19 [#61160] Bump rev to 1.0.3
    [cm4-baseboard.kicad_sch, compute-module.kicad_sch, csi.kicad_sch, display.kicad_sch, ethernet.kicad_sch, nvme-micro-sd.kicad_sch, peripherals.kicad_sch, supply.kicad_sch]
2024-06-26 [#61473] Bump date on PCB
2024-06-27 [#61473] Remove cm4 silkscreen border
2024-07-01 [#60106] PCB: Add dimensions, conn. descriptions
2024-07-01 [#60106] PCB: Change frame size to A4
2024-07-01 [#60106] PCB: Clean DRC
2024-07-01 [#60106] PCB: Align CM4 module virtual footprint
2024-07-08 [#61534] Clean DNP properites
    [compute-module.kicad_sch, nvme-micro-sd.kicad_sch, peripherals.kicad_sch]
2024-08-02 [#63565] Synchronize components with library, bump revision to 1.0.4
    [cm4-baseboard.kicad_sch, compute-module.kicad_sch, csi.kicad_sch, display.kicad_sch, ethernet.kicad_sch, nvme-micro-sd.kicad_sch, peripherals.kicad_sch, supply.kicad_sch]
2024-08-02 [#63565] Add Q304 bypass
    [supply.kicad_sch]
2024-08-02 [#63565] Add Q210 pull-down
    [compute-module.kicad_sch]
2024-08-02 [#63565] Add DC connector polarity marking
2024-08-05 [#63565] SQS401EN-T1 remove "exclude from BOM" parameter
    [supply.kicad_sch, usb.kicad_sch]
2024-08-05 [#63565] Update SQS401EN-T1
    [supply.kicad_sch]
2024-09-12 [#65638] Fix green LEDs, bump revision to 1.0.5
    [cm4-baseboard.kicad_sch, compute-module.kicad_sch, csi.kicad_sch, display.kicad_sch, ethernet.kicad_sch, nvme-micro-sd.kicad_sch, peripherals.kicad_sch, supply.kicad_sch]
2024-09-13 [#65638] Post review fixes
    [cm4-baseboard.kicad_sch, compute-module.kicad_sch, csi.kicad_sch, display.kicad_sch, ethernet.kicad_sch, nvme-micro-sd.kicad_sch, peripherals.kicad_sch, supply.kicad_sch]
